oukej1/Home-automation/README.md

# Home-automation
Repository for home automation design, and codes.
