oukej1/Home-automation/House_Loucka/README.md

Folder for preparation of arduino and RPI based home automation for house in Loučka.
