oukej1/Home-automation/House_Loucka/ELI_tabulky.ods

Sheet: ZasuvkoveOkruhy
Rozvaděč | Podlaží | Místnost | Okruh | Počet | Popis | Příkon | Hnízda | počet
RH | 1NP | 102 | 100 | 6 | Zásuvky |  | 1 | 2
RH | 1NP | 102 | 101 | 1 | TV |  | 3 | 1 | 3
RH | 1NP | 102 | 102 | 1 | Myčka |  | 1 | 2 | 1
RH | 1NP | 102 | 103 | 1 | Mikrovlnná trouba |  | 1 | 2 | 1
RH | 1NP | 102 | 104 | 1 | Trouba | 3500W | 1 | 2 | 1
RH | 1NP | 102 | 105 | 5 | Zásuvky kuchyňská linka |  | 1 | 2
RH | 1NP | 102 | 106 | 1 | Lednice |  | 1 | 2 | 1
RH | 1NP | 102 | 107 | 1 | Digestoř |  | 1 | 1
RH | 1NP | 102 | 108 | 1 | Indukční varná deska | 7360W
RH | 1NP | 103;105 | 109 | 7 | Zásuvky
RH | 1NP | 103;104;105;106 | 110 | 5 | PC + AP
RH | 1NP | 104; 106 | 111 | 4 | Zásuvky
RH | 1NP | 108;109 | 112 | 5 | zásuvky
RH | 1NP | 110;101 | 113 | 3 | zásuvky
RH | 1NP | 110 | 114 | 1 | Pračka
RH | 1NP | 110 | 115 | 1 | Sušička
RP | 1NP | 100 | 116 | 4 | Zásuvky venkovní + robosekačka |  | 1 | 2
RP | 1NP | 113 | 117 | 2 | Zásuvky
RP | 1NP | 112;100 | 118 | 3 | Zásuvky – Soustruh | 6000W
RP | 1NP | 112;100 | 119 | 1 | Zásuvka 400V
RP | 1NP | 112;100 | 120 | 3 | Zásuvky
RP | 1NP | 100 | 121 | 1 | Zásuvka 400V |  | 1 | 1
RP | 1NP | 100 | 122 | 1 | Vodárna pitná voda (čerpadlo + 2 zásuvky úpravna) | 1550w + 2x100W | 3 | 2
RP | 1NP | 100 | 123 | 1 | Vodárna užitková voda | 910W | 1 | 2
RP | 1NP | 100 | 124 | 1 | Brána + videovrátný
RP | 1NP | 100 | 125 | 1 | Studna |  | 1 | 2
RP | 1NP | 100 | 126 | 1 | Dešťovka |  | 1 | 2
RH | 2NP | 202 | 201 | 5 | Zásuvky pracovna
RH | 2NP | 202 | 202 | 3 | Zásuvky pracovna PC + AP
RH | 2NP | 201;203;204 | 203 | 6 | Zásuvky + zásuvka koupelna skřínka
RH | 2NP | 206 | 204 | 5 | Zásuvky
RH | 2NP | 202 | 205 | 1 | Zásuvka Příprava – Přímotop možnost sjednotit s podlahovkou | 1000W
RH | 2NP | 206 | 206 | 1 | Zásuvka Příprava – Přímotop možnost sjednotit s podlahovkou | 1000W
RH | 2NP | 205 | 207 | 1 | Bojler | 2500W
RH | 2NP | 205 | 208 | 1 | Rekuperace
RH | 2NP | 205 | 209 | 1 | Slaboproudý rozvaděč
RH | 2NP | 205 | 210 | 1 | Rezerva
RH | 2NP | 200 | 211 | 1 | Zásuvka venkovní – vánoční osvětlení
RH | 2NP | 205 | 212 | 1 | Cirkulační čerpadlo

Sheet: Svetla
Rozvaděč | Podlaží | Místnost | Okruh | Počet | Popis | Arduino | SSR relay
RH | 1NP | 101 | L1011 | 1 | Hala Strop | Ard1 | SSR1
RH | 1NP | 101 | L1012 | 1 | Hala schody stěna | Ard1 | SSR1
RH | 1NP | 102 | L1021 | 1 | Jídelna strop | Ard1 | SSR1
RH | 1NP | 102 | L1022 | 1 | Kuchyň strop | Ard1 | SSR1
RH | 1NP | 102 | L1023 | 1 | Kuchyň Led pásek linka | Ard1 | SSR1
RH | 1NP | 102 | L1024 | 1 | Obývák stůl | Ard1 | SSR1
RH | 1NP | 102 | L1024 | 1 | Obývák gauč | Ard1 | SSR1
RH | 1NP | 102 | L1025 | 1 | Vstup do denní místnosti | Ard1 | SSR1
RH | 1NP | 103 | L1031 | 1 | Strop pracovna | Ard1 | SSR2
RH | 1NP | 104 | L1041 | 2 | Strop chodba | Ard1 | SSR2
RH | 1NP | 104 | L1042 | 2 | Led světlo ú podlahy | Ard1 | SSR2
RH | 1NP | 105 | L1051 | 1 | Strop Pokoj I | Ard1 | SSR2
RH | 1NP | 106 | L1061 | 1 | Strop Pokoj II | Ard1 | SSR2
RH | 1NP | 107 | L1071 | 1 | Strop šatna | Ard1 | SSR2
RH | 1NP | 108 | L1081 | 1 | Strop ložnice | Ard1 | SSR2
RH | 1NP | 109 | L1091 | 2 | Koupelna strop + skřínka | Ard1 | SSR2
RH | 1NP | 110 | L1101 | 3 | Koupelna strop + 2x skřínka | Ard1 | SSR3
RH | 1NP | 111 | L1111 | 1 | WC strop | Ard1 | SSR3
RH | 1NP | 100 | L1001 | 2 | Exteriér světla u vstupu | Ard1 | SSR3
RH | 1NP | 100 | L1002 | 2 | Exteriér světla terasa | Ard1 | SSR3
RH | 1NP | 100 | L1003 | 5 | Exteriér světla pokoje | Ard1 | SSR3
RH | 1NP | 100 | L1004 | 1 | Exteriér světlo ložnice | Ard1 | SSR3
RP | 1NP | 112 | L1121 | 2 | Strop dílna | Ard5 | SSR12
RP | 1NP | 113 | L1131 | 1 | Strop sklad | Ard5 | SSR12
RH | 2NP | 202 | L2021 | 1 | Strop pracovna II | Ard1 | SSR3
RH | 2NP | 201 | L2011 | 2 | Strop Galerie | Ard1 | SSR3
RH | 2NP | 201 | L1012 | 1 | Schodiště | Ard1 | SSR4
RH | 2NP | 203 | L2031 | 1 | Šatna | Ard1 | SSR4
RH | 2NP | 204 | L2041 | 2 | Koupelna strop + skřínka | Ard1 | SSR4
RH | 2NP | 205 | L2051 | 1 | Technická místnost | Ard1 | SSR4
RH | 2NP | 206 | L2061 | 1 | Herna | Ard1 | SSR4
RH | 2NP | 200 | L2001 | 1 | Venkovní plochá střecha | Ard1 | SSR4

Sheet: Topeni
Rozvaděč | Podlaží | Místnost | Okruh | Počet | Popis | Příkon | Arduino | SSR relay
RH | 1NP | 101 | H1011 | 1 | Podlahové topení | 400 W | Ard2 | SSR5
RH | 1NP | 102 | H1021 | 1 | Podlahové topení | 1700 W | Ard2 | SSR5
RH | 1NP | 102 | H1022 | 1 | Podlahové topení | 950 W | Ard2 | SSR5
RH | 1NP | 103 | H1031 | 1 | Podlahové topení | 520 W | Ard2 | SSR5
RH | 1NP | 105 | H1051 | 1 | Podlahové topení | 750 W | Ard2 | SSR5
RH | 1NP | 106 | H1061 | 1 | Podlahové topení | 750 W | Ard2 | SSR5
RH | 1NP | 108 | H1081 | 1 | Podlahové topení | 600 W | Ard2 | SSR5
RH | 1NP | 109 | H1091 | 1 | Podlahové topení | 200 W | Ard2 | SSR5
RH | 1NP | 109 | H1092 | 1 | Žebřík | 500 W | Ard2 | SSR6
RH | 1NP | 110 | H1101 | 1 | Podlahové topení | 550 W | Ard2 | SSR6
RH | 1NP | 110 | H1102 | 1 | Žebřík | 500 W | Ard2 | SSR6
RH | 1NP | 111 | H1111 | 1 | Žebřík | 310 W | Ard2 | SSR6
RP | 1NP | 112+100 | H1121 | 3 | Vyhřívaná střešní vpusť | 30 W | Ard5 | SSR12
RH | 2NP | 202 | H2021 | 1 | Podlahové topení | 1700 W | Ard2 | SSR6
RH | 2NP | 204 | H2041 | 1 | Podlahové topení | 550W | Ard2 | SSR6
RH | 2NP | 204 | H2042 | 1 | Žebřík | 500 W | Ard2 | SSR6
RH | 2NP | 206 | H2061 | 1 | Podlahové topení | 1300 W | Ard2 | SSR6
RP | 1NP | 112 | H1122 | 1 | Příomotop | 1000W | Ard5 | SSR12
RP | 1NP | 112 | H1123 | 1 | Ventilátor | xx | Ard5 | SSR12

Sheet: Zaluzie
Rozvaděč | Podlaží | Místnost | Okruh | Počet | Popis | Příkon | Arduino
RH | 1NP | 102 | SH1021 | 1 | Žaluzie HS fix | 95W | Ard2 | SSR9
RH | 1NP | 102 | SH1022 | 1 | Žaluzie HS otvírací | 95W | Ard2 | SSR9
RH | 1NP | 102 | SH1023 | 1 | Žaluzie Fix rohové | 95W | Ard2 | SSR9
RH | 1NP | 102 | SH1024 | 1 | Žaluzie Kuchyňská linka | 95W | Ard2 | SSR9
RH | 1NP | 103 | SH1031 | 1 | Žaluzie Pracovna | 95W | Ard2 | SSR10
RH | 1NP | 105 | SH1051 | 1 | Žaluzie Pokoj I | 95W | Ard2 | SSR10
RH | 1NP | 106 | SH1061 | 1 | Žaluzie Pokoj II | 95W | Ard2 | SSR10
RH | 1NP | 108 | SH1081 | 1 | Žaluzie Ložnice | 95W | Ard2 | SSR10
RH | 2NP | 202 | SH2021 | 1 | Žaluzie Pracovna II | 95W | Ard2 | SSR11
RH | 2NP | 206 | SH2061 | 1 | Žaluzie Herna | 95W | Ard2 | SSR11

Sheet: Zvuk
Rozvaděč | Podlaží | Místnost | Okruh | Počet | Popis | Příkon
RH | 1NP | 102 | SND1021 | 3 | Reporduktor kuchyně + obývák
RH | 1NP | 103 | SND1031 | 1 | Reporduktor Pracovna I
RH | 1NP | 105 | SND1051 | 1 | Reproduktor Pokoj I
RH | 1NP | 106 | SND1061 | 1 | Reproduktor Pokoj II
RH | 2NP | 202 | SND2021 | 1 | Reproduktor Pracovna II
RH | 2NP | 206 | SND2061 | 1 | Repoduktor Herna

Sheet: FVE
Rozvaděč | Podlaží | Místnost | Počet | Popis | Typ
RH | 1NP | 113 | 1 | Střídač | SUN-10K-SG04LP3
RH | 1NP | 113 | 1 | Baterie | Somi 10,24 kWh
RH | 1NP | Exteriér | 2 | Wallbox | EVmate 01/2-3-16 STR

Sheet: Sheet8
Distribution box | ID | Room | Sensor | Count | Arduino | Pin count
RH | 101 | hala | DHT22 | 1 | Ard3 | 1
RH | 102 | denní místnost | DHT22
RH | 103 | Pracovna 1 | DHT22
RH | 104 | chodba | DHT22 | 1 | Ard3 | 1
RH | 105 | Pokoj 1 | DHT22
RH | 106 | Pokoj 2 | DHT22
RH | 107 | Šatna | DHT22 | 1 | Ard3 | 1
RH | 108 | Ložnice | DHT22
RH | 109 | Koupelna II | DHT22 | 1 | Ard3 | 1
RH | 110 | Koupelna I | DHT22 | 1 | Ard3 | 1
RH | 111 | WC | DHT22 | 1 | Ard3 | 1
RP1 | 112 | Dílna | DHT22
RP1 | 113 | Sklad | DHT22 | 1 | Ard5 | 1
RH | 201 | Galerie | DHT22 | 1 | Ard3 | 1
RH | 202 | Pracovna 2 | DHT22
RH | 203 | Šatna | DHT22 | 1 | Ard3 | 1
RH | 204 | koupelna | DHT22 | 1 | Ard3 | 1
RH | 205 | Technologie | DHT22 | 1 | Ard3 | 1
RH | 206 | Herna | DHT22
RP1 | 000 | Outdoor | DHT22 | 1 | Ard5 | 1
RH | 101 | hala | HC-SR501 | 1 | Ard3 | 1
RH | 102 | denní místnost | HC-SR501 | 2 | Ard3 | 2
RH | 103 | Pracovna 1 | HC-SR501 | 1 | Ard3 | 1
RH | 104 | chodba | HC-SR501 | 1 | Ard3 | 1
RH | 105 | Pokoj 1 | HC-SR501 | 1 | Ard3 | 1
RH | 106 | Pokoj 2 | HC-SR501 | 1 | Ard3 | 1
RH | 107 | Šatna | HC-SR501 | 1 | Ard3 | 1
RH | 108 | Ložnice | HC-SR501 | 1 | Ard3 | 1
RH | 109 | Koupelna II | HC-SR501 | 1 | Ard3 | 1
RH | 110 | Koupelna I | HC-SR501 | 1 | Ard3 | 1
RH | 111 | WC | HC-SR501 | 1 | Ard3 | 1
RP1 | 112 | Dílna | HC-SR501 | 1 | Ard5 | 1
RP1 | 113 | Sklad | HC-SR501 | 1 | Ard5 | 1
RH | 201 | Galerie | HC-SR501 | 1 | Ard3 | 1
RH | 202 | Pracovna 2 | HC-SR501 | 1 | Ard3 | 1
RH | 203 | Šatna | HC-SR501 | 1 | Ard3 | 1
RH | 204 | koupelna | HC-SR501 | 1 | Ard3 | 1
RH | 205 | Technologie | HC-SR501 | 1 | Ard3 | 1
RH | 206 | Herna | HC-SR501 | 1 | Ard3 | 1
RP1 | 000 | Outdoor | HC-SR501 | 3 | Ard5 | 3
RH | 101 | hala | DS18B20 5m | 1 | Ard3 | 1
RH | 102 | denní místnost | DS18B20 5m | 2 | Ard3 | 0
RH | 103 | Pracovna 1 | DS18B20 5m | 1 | Ard3 | 0
RH | 104 | chodba | DS18B20 5m |  | Ard3 | 0
RH | 105 | Pokoj 1 | DS18B20 5m | 1 | Ard3 | 0
RH | 106 | Pokoj 2 | DS18B20 5m | 1 | Ard3 | 0
RH | 107 | Šatna | DS18B20 5m |  | Ard3 | 0
RH | 108 | Ložnice | DS18B20 5m | 1 | Ard3 | 0
RH | 109 | Koupelna II | DS18B20 5m | 1 | Ard3 | 0
RH | 110 | Koupelna I | DS18B20 5m | 1 | Ard3 | 0
RH | 111 | WC | DS18B20 5m |  | Ard3 | 0
RP1 | 112 | Dílna | DS18B20 5m |  |  | 0
RP1 | 113 | Sklad | DS18B20 5m |  |  | 0
RH | 201 | Galerie | DS18B20 5m |  | Ard3 | 0
RH | 202 | Pracovna 2 | DS18B20 5m | 1 | Ard3 | 0
RH | 203 | Šatna | DS18B20 5m |  | Ard3 | 0
RH | 204 | koupelna | DS18B20 5m | 1 | Ard3 | 0
RH | 205 | Technologie | DS18B20 5m |  | Ard3 | 0
RH | 206 | Herna | DS18B20 5m | 1 | Ard3 | 0
RP1 | 000 | Outdoor | DS18B20 5m
RH | 101 | hala | TSL2591
RH | 102 | denní místnost | TSL2591 | 2 | Ard3 | 2
RH | 103 | Pracovna 1 | TSL2591 | 1 | Ard3 | 1
RH | 104 | chodba | TSL2591
RH | 105 | Pokoj 1 | TSL2591 | 1 | Ard3 | 1
RH | 106 | Pokoj 2 | TSL2591 | 1 | Ard3 | 1
RH | 107 | Šatna | TSL2591
RH | 108 | Ložnice | TSL2591 | 1 | Ard3 | 1
RH | 109 | Koupelna II | TSL2591
RH | 110 | Koupelna I | TSL2591
RH | 111 | WC | TSL2591
RP1 | 112 | Dílna | TSL2591
RP1 | 113 | Sklad | TSL2591
RH | 201 | Galerie | TSL2591
RH | 202 | Pracovna 2 | TSL2591 | 1 | Ard3 | 1
RH | 203 | Šatna | TSL2591
RH | 204 | koupelna | TSL2591
RH | 205 | Technologie | TSL2591
RH | 206 | Herna | TSL2591 | 1 | Ard3 | 1
RP1 | 000 | Outdoor | TSL2591 | 4 | Ard5 | 4
RH | 101 | hala | Magnetic door sensor | 1 | Ard4 | 1
RH | 102 | denní místnost | Magnetic door sensor | 3 | Ard4 | 3
RH | 103 | Pracovna 1 | Magnetic door sensor | 2 | Ard4 | 2
RH | 104 | chodba | Magnetic door sensor
RH | 105 | Pokoj 1 | Magnetic door sensor | 2 | Ard4 | 2
RH | 106 | Pokoj 2 | Magnetic door sensor | 2 | Ard4 | 2
RH | 107 | Šatna | Magnetic door sensor
RH | 108 | Ložnice | Magnetic door sensor | 2 | Ard4 | 2
RH | 109 | Koupelna II | Magnetic door sensor
RH | 110 | Koupelna I | Magnetic door sensor | 1 | Ard4 | 1
RH | 111 | WC | Magnetic door sensor
RP1 | 112 | Dílna | Magnetic door sensor | 1 | Ard5 | 1
RP1 | 113 | Sklad | Magnetic door sensor | 1 | Ard5 | 1
RH | 201 | Galerie | Magnetic door sensor
RH | 202 | Pracovna 2 | Magnetic door sensor | 2 | Ard4 | 2
RH | 203 | Šatna | Magnetic door sensor
RH | 204 | koupelna | Magnetic door sensor
RH | 205 | Technologie | Magnetic door sensor
RH | 206 | Herna | Magnetic door sensor | 2 | Ard4 | 2
RP1 | 000 | Outdoor | Magnetic door sensor
RH | 101 | hala | SCD41
RH | 102 | denní místnost | SCD41 | 2 | Ard4 | 2
RH | 103 | Pracovna 1 | SCD41 | 1 | Ard4 | 1
RH | 104 | chodba | SCD41
RH | 105 | Pokoj 1 | SCD41 | 1 | Ard4 | 1
RH | 106 | Pokoj 2 | SCD41 | 1 | Ard4 | 1
RH | 107 | Šatna | SCD41
RH | 108 | Ložnice | SCD41 | 1 | Ard4 | 1
RH | 109 | Koupelna II | SCD41
RH | 110 | Koupelna I | SCD41
RH | 111 | WC | SCD41
RP1 | 112 | Dílna | SCD41 | 1 | Ard5 | 1
RP1 | 113 | Sklad | SCD41
RH | 201 | Galerie | SCD41
RH | 202 | Pracovna 2 | SCD41 | 1 | Ard4 | 1
RH | 203 | Šatna | SCD41
RH | 204 | koupelna | SCD41
RH | 205 | Technologie | SCD41
RH | 206 | Herna | SCD41 | 1 | Ard4 | 1
RP1 | 000 | Outdoor | SCD41

Sheet: Sensors_Incl_CO2
ID | Room | Area | DHT22 | HC-SR501 | DS18B20 5m | TSL2591 | Magnetic door sensor | SCD41 | Total
101 | hala | 6.34 | 1 | 1 | 1 |  | 1 |  | 4
102 | denní místnost | 43.14 |  | 2 | 2 | 2 | 3 | 2 | 11
103 | Pracovna 1 | 8.17 |  | 1 | 1 | 1 | 2 | 1 | 6
104 | chodba | 5.65 | 1 | 1 |  |  |  |  | 2
105 | Pokoj 1 | 12.16 |  | 1 | 1 | 1 | 2 | 1 | 6
106 | Pokoj 2 | 12.15 |  | 1 | 1 | 1 | 2 | 1 | 6
107 | Šatna | 2.12 | 1 | 1 |  |  |  |  | 2
108 | Ložnice | 10.04 |  | 1 | 1 | 1 | 2 | 1 | 6
109 | Koupelna II | 2.33 | 1 | 1 | 1 |  |  |  | 3
110 | Koupelna I | 6.23 | 1 | 1 | 1 |  | 1 |  | 4
111 | WC | 1.2 | 1 | 1 |  |  |  |  | 2
112 | Dílna | 14.62 |  | 1 |  |  | 1 | 1 | 3
113 | Sklad | 5.83 | 1 | 1 |  |  | 1 |  | 3
201 | Galerie | 6.21 | 1 | 1 |  |  |  |  | 2
202 | Pracovna 2 | 27.66 |  | 1 | 1 | 1 | 2 | 1 | 6
203 | Šatna | 5.05 | 1 | 1 |  |  |  |  | 2
204 | koupelna | 6.44 | 1 | 1 | 1 |  |  |  | 3
205 | Technologie | 3.79 | 1 | 1 |  |  |  |  | 2
206 | Herna | 21.78 |  | 1 | 1 | 1 | 2 | 1 | 6
000 | Outdoor | 0 | 1 | 3 |  | 4 |  |  | 8
 | Total |  | 12 | 23 | 12 | 12 | 19 | 9 | 87
