oukej1/Home-automation/House_Loucka/Sensor_boxes/Sensor_Box_THCO_assembly.FCStd

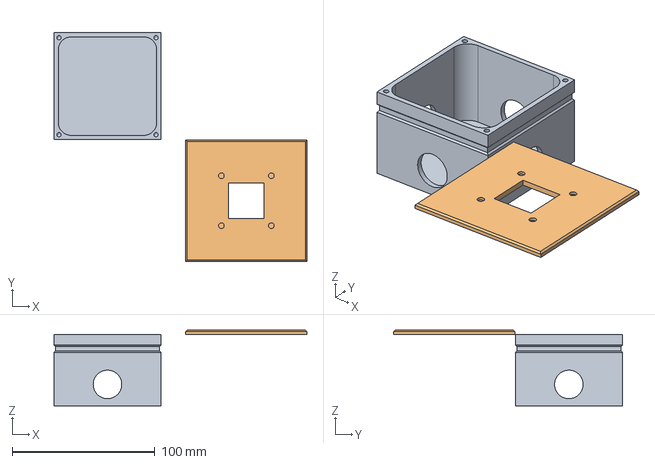
[picture p1: CAD file, 2024-05-08]
House_Loucka/Sensor_boxes/Sensor_Box_THCO_assembly.FCStd
177.3 x 160.3 x 53.0 mm
Sensor_box_001
Sensor_cover_Tem_hum_CO_001
