oukej1/Home-automation/House_Loucka/Sensor_boxes/Sensor_box.FCStd

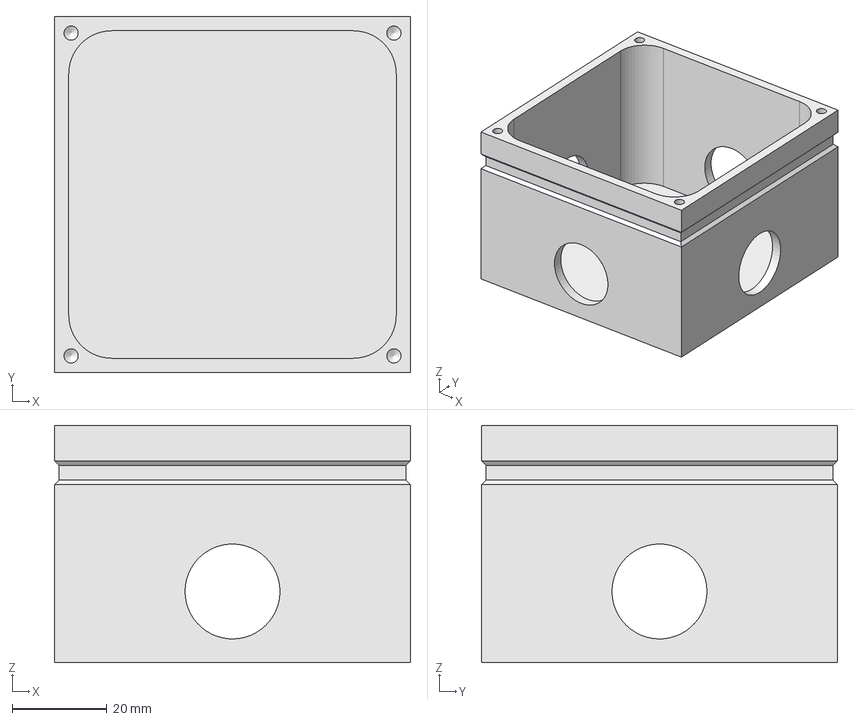
[picture p2: CAD file, 2024-05-08]
House_Loucka/Sensor_boxes/Sensor_box.FCStd
75.0 x 75.0 x 50.0 mm
