oukej1/Home-automation/House_Loucka/Sensor_boxes/Sensor_cover_Tem_hum_CO.FCStd

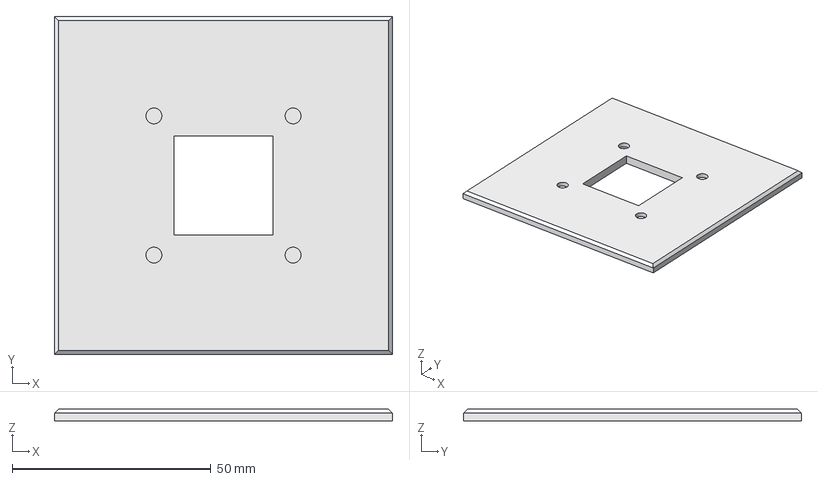
[picture p3: CAD file, 2024-05-08]
House_Loucka/Sensor_boxes/Sensor_cover_Tem_hum_CO.FCStd
85.0 x 85.0 x 3.00 mm
