oukej1/Home-automation/Test_house_Hurka/README.md

Folder for testing of arduino and RPI based home automation in Hůrka.
