oukej1/Home-automation/(threads)

Thread 1 (2024-05-28):

Vyřešit u světel

oukej1, 2024-05-28:
Rozvržení žárovek venku a jejich ovládání L1003 - L1006
Potvrdit obývák - zrušení středových světel
Potvrdit LED pásky v chodbě L1042
Potvrdit 2x B1007 tlačítka
Potvrdit B1001
Potvrdit B1022,1023

oukej1, 2024-06-27:
Vše L1003
V obýváku zrušeno středové
Led potvrzeny 2 ks
B1007 zrušeno
B1001 přesunuto a jedno vevnitř
B1022.1023 potvrzeno lednice je 20cm od kraje

Closed 2024-06-27.
