oukej1/Home-automation/House_Loucka/Rozvadece/Rozvaděč RE1_HonzaLazecky.pdf

Akce: | Název: Liniové schéma RE1 | StavbyDay s.r.o. Karasova 1130/23 709 00, Ostrava-Mariánské Hory IČ: 07522240 DIČ: CZ07522240 mobil: +420 722 946 876 email: info@StavbyDay.cz | Datum: 22.09.2022 | Vypracoval: | Schválil: RD Lazečtí | Počet listů:
Místo: Olbramice | | | | | | Číslo listu:

- ROZVADĚČ V OCELOPLECHOVÉM SKŘÍŇOVÉM PROVEDENÍ: 1100x1800x400mm (MAX. rozměry) - MONTÁŽ V PROVEDENÍ NA OMÍTKU - PŘÍVOD SHORA, VÝVODY VRCHEM - OBDÉLNÍKOVÉ OTVORY PRO SILOVÉ A SLABOPROUDÉ KABELY ZVLÁŠŤ - SVORKOVNICE N a PE NESCHOVÁVAT ZA SEBE - KRYTÍ: IP40/IP20 - PŘED INSTALACÍ PRVKU LOXONE, NEJPRVE DŮKLADNĚ PROSTUDOVAT NÁVOD

1800 mm

1100 mm

400 mm

# ROZVODNÁ SOUSTAVA: 3 NPE, AC 50Hz, 400V / TN-C-S

ZÁKLADNÍ OCHRANA PŘED NEBEZPEČNÝM DOTYKEM DLE ČSN 33 2000-4-41: SAMOČINNÝM ODPOJENÍM OD ZDROJE

# ZVÝŠENÁ: DOPLŇKOVÝM POSPOJOVÁNÍM, PROUDOVÝM CHRÁNIČEM - V NÁSLEDNÝCH OBVODECH

# Liniové schéma rozvodnice

Prvky Loxone, které dodá fa StavbyDay: 1x TDK-Lambda DRF100-24-4,2A (ZD1) 1x TDK-Lambda DRF100-24-0,4A (ZD2) 3x TDK-Lambda DRF240-24-10A (ZD3, ZD4, ZD5) 1x Loxone 3-fázový elektroměr (Modbus) (U1) 1x Loxone Miniserver 2. generace (U2) 4x Loxone Relé Extension (U3, U4, U5, U6) 2x Loxone Modbus Extension (U7, U8) 2x Loxone 1-Wire Extension (U9, U10) 1x Loxone Air Base Extension (U11) 1x Loxone DI Extension (U12) 1x Loxone Tree Extension (U13) 3x Loxone RGBW 24V Dimmer Tree (U14, U15) 1x Loxone AduioServer (U16) 1x Stereo Extension (U17) - pouze vynechat místo pro případné dosazení

Pro propojení datových linek „LOXONE bus”, „TREE bus”, „Tree Turbo”, „Modbus” použít kroucený pár. Propojit všechny mínusové svorky „-V” všech 24VDC zdrojů.

| X1 X2 X3 | X6
H1 | H4 IN1 | T1 T2 T3 T4 T5 T6 T7 T8 T9 T10 T11 T12 | T15 T16 K1 K2

# Silové svorky 230VAC

# Slaboproudé svorky 24VDC

# U2(9p) U3(9p) U4(9p) U5(9p) U6(9p) U7(2p)

U13(2p)

# U8(2p) U9(2p) U10(2p) U11(2p) U12(2p)

# Přibližné rozmístění a pořadí prvků Loxone

X4 | X7 U14(2p)
H3 | T13 T14

U16(9p)

A1

U15(2p)

X5
IN2

U16(2p)

U1

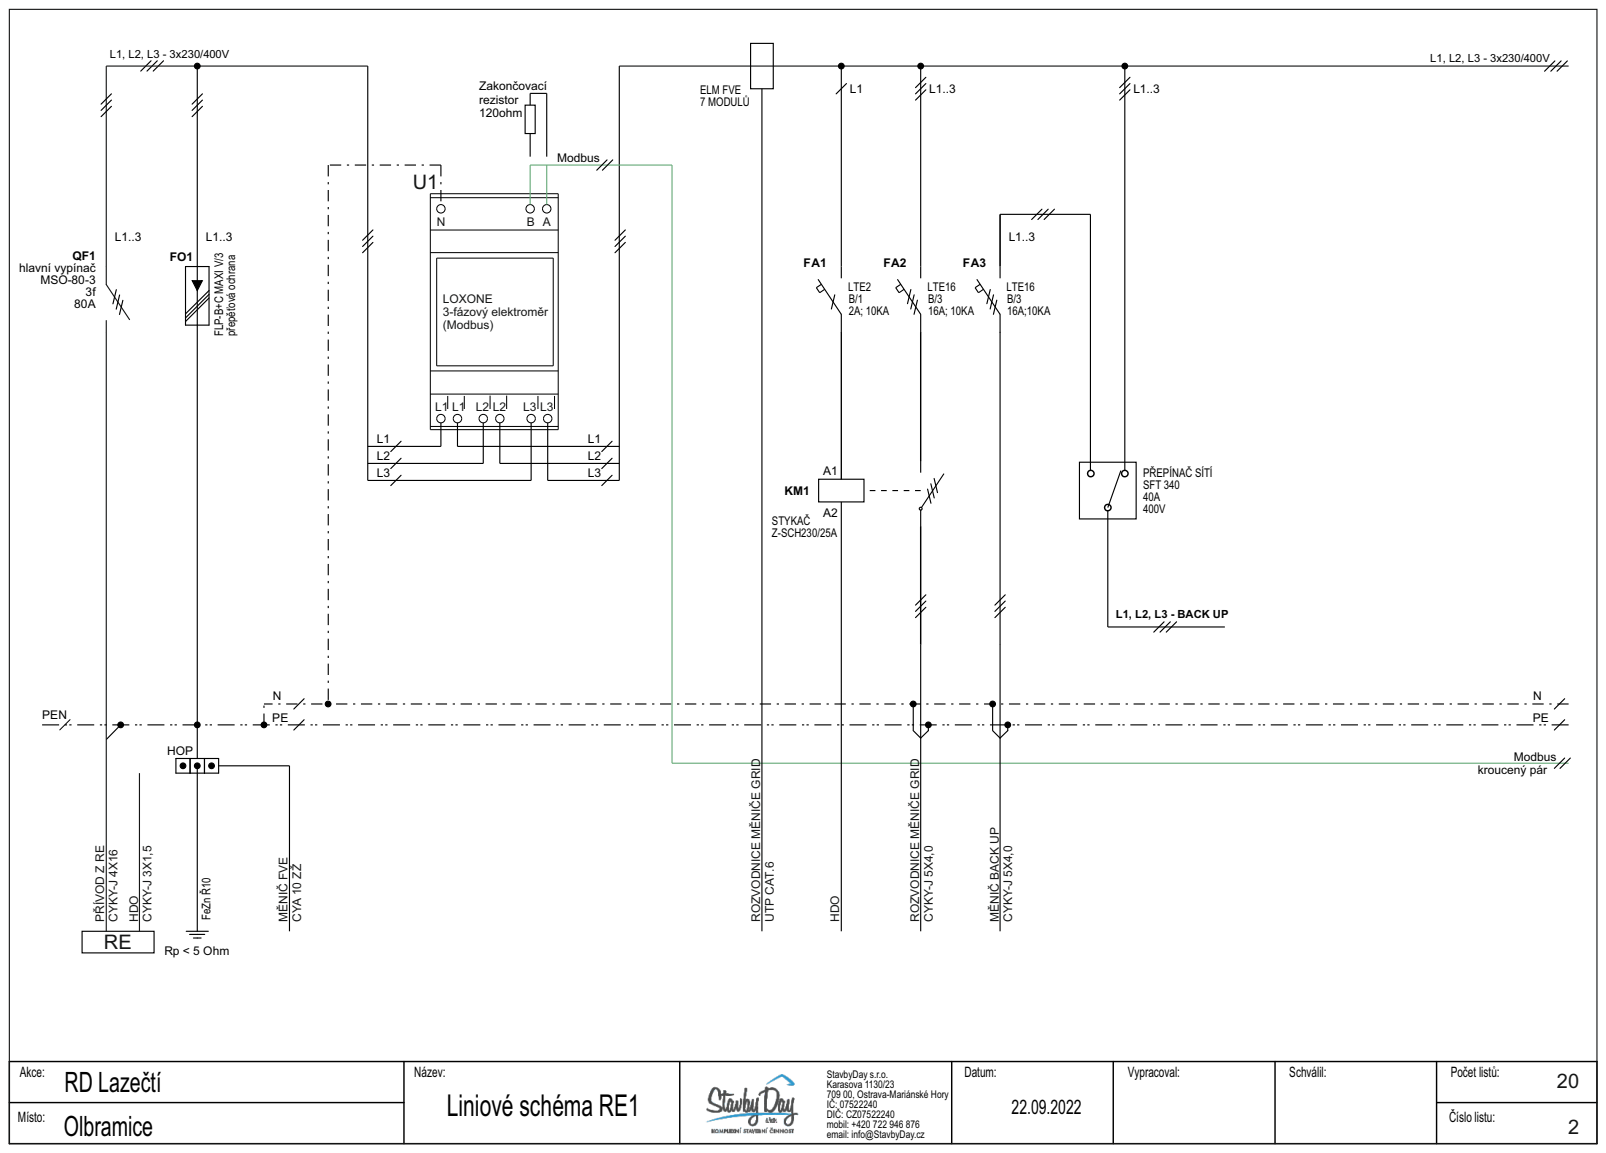
[picture p4: page 2]
QF1 hlavní vypínač MSO-80-3 3f 80A; FeZn Ř10; Rp < 5 Ohm; HOP; FLP-B+C MAXI V/3; přepěťová ochrana; PEN; LOXONE 3-fázový elektroměr (Modbus); Modbus; Zakončovací rezistor 120ohm; kroucený pár; PŘÍVOD Z RE; CYKY-J 4X16; HDO; CYKY-J 3X1,5; LTE16 B/3 16A;10KA; CYKY-J 5X4,0; LTE16 B/3 16A; 10KA; LTE2 B/1 2A; 10KA; MĚNIČ FVE CYA 10 ZŽ; PŘEPÍNAČ SÍTÍ SFT 340 40A 400V; STYKAČ Z-SCH230/25A; L1, L2, L3 - BACK UP; UTP CAT.6; ELM FVE 7 MODULŮ

L2 | L2
L3 | L3

ROZVODNICE MĚNIČE GRID

MĚNIČ BACK UP

# FA101ZÁSUVKA TERASA

# FA102ZÁSUVKA GARÁŽ

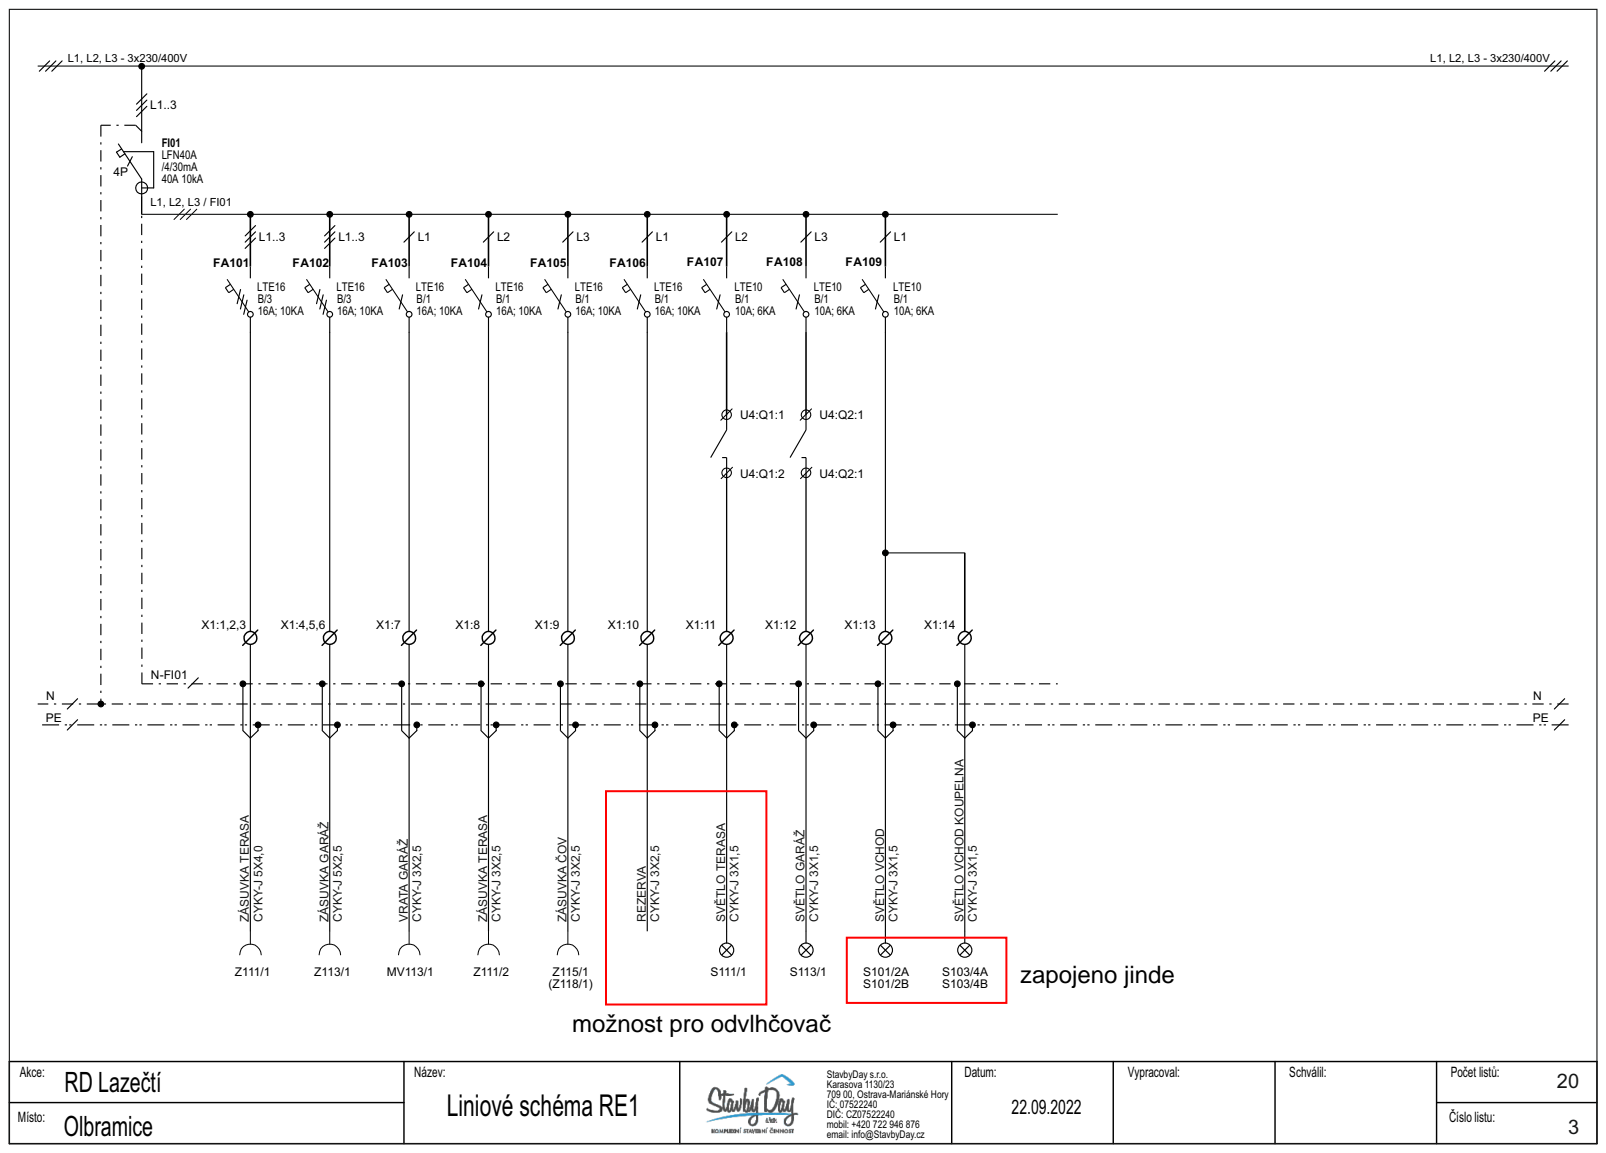
[picture p5: page 3]
FI01 LFN40A /4/30mA 40A 10kA 4P; LTE16 B/3 16A; 10KA; CYKY-J 5X4,0; CYKY-J 5X2,5; FA103VRATA GARÁŽ; CYKY-J 3X2,5; LTE16 B/1 16A; 10KA; FA105ZÁSUVKA ČOV; FA106REZERVA; LTE10 B/1 10A; 6KA; SVĚTLO TERASA; CYKY-J 3X1,5; FA104ZÁSUVKA TERASA; SVĚTLO VCHOD; SVĚTLO GARÁŽ; možnost pro odvlhčovač; zapojeno jinde

X1:14 SVĚTLO VCHOD KOUPELNA

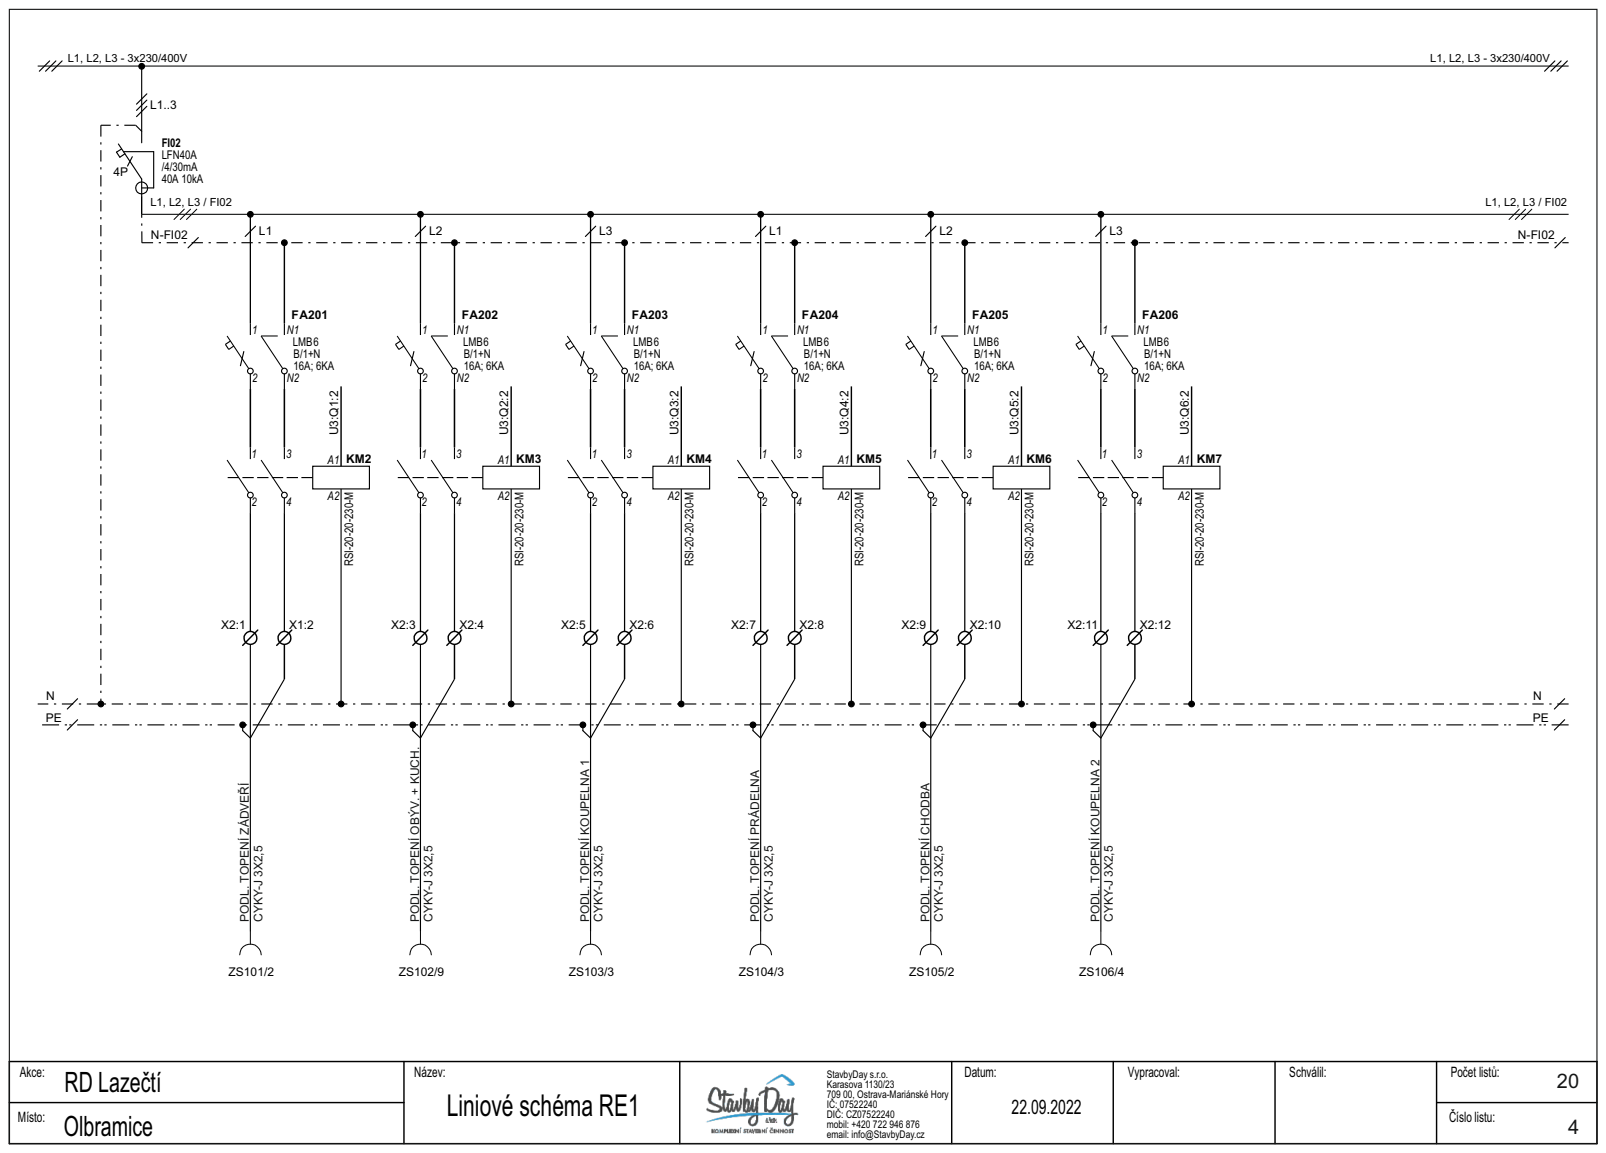
[picture p6: page 4]
FI02 LFN40A /4/30mA 40A 10kA 4P; LMB6 B/1+N 16A; 6KA; RSI-20-20-230-M; CYKY-J 3X2,5

PODL. TOPENÍ OBÝV. + KUCH.

PODL. TOPENÍ KOUPELNA 1

PODL. TOPENÍ PRÁDELNA

PODL. TOPENÍ KOUPELNA 2

PODL. TOPENÍ ZÁDVEŘÍ

PODL. TOPENÍ CHODBA

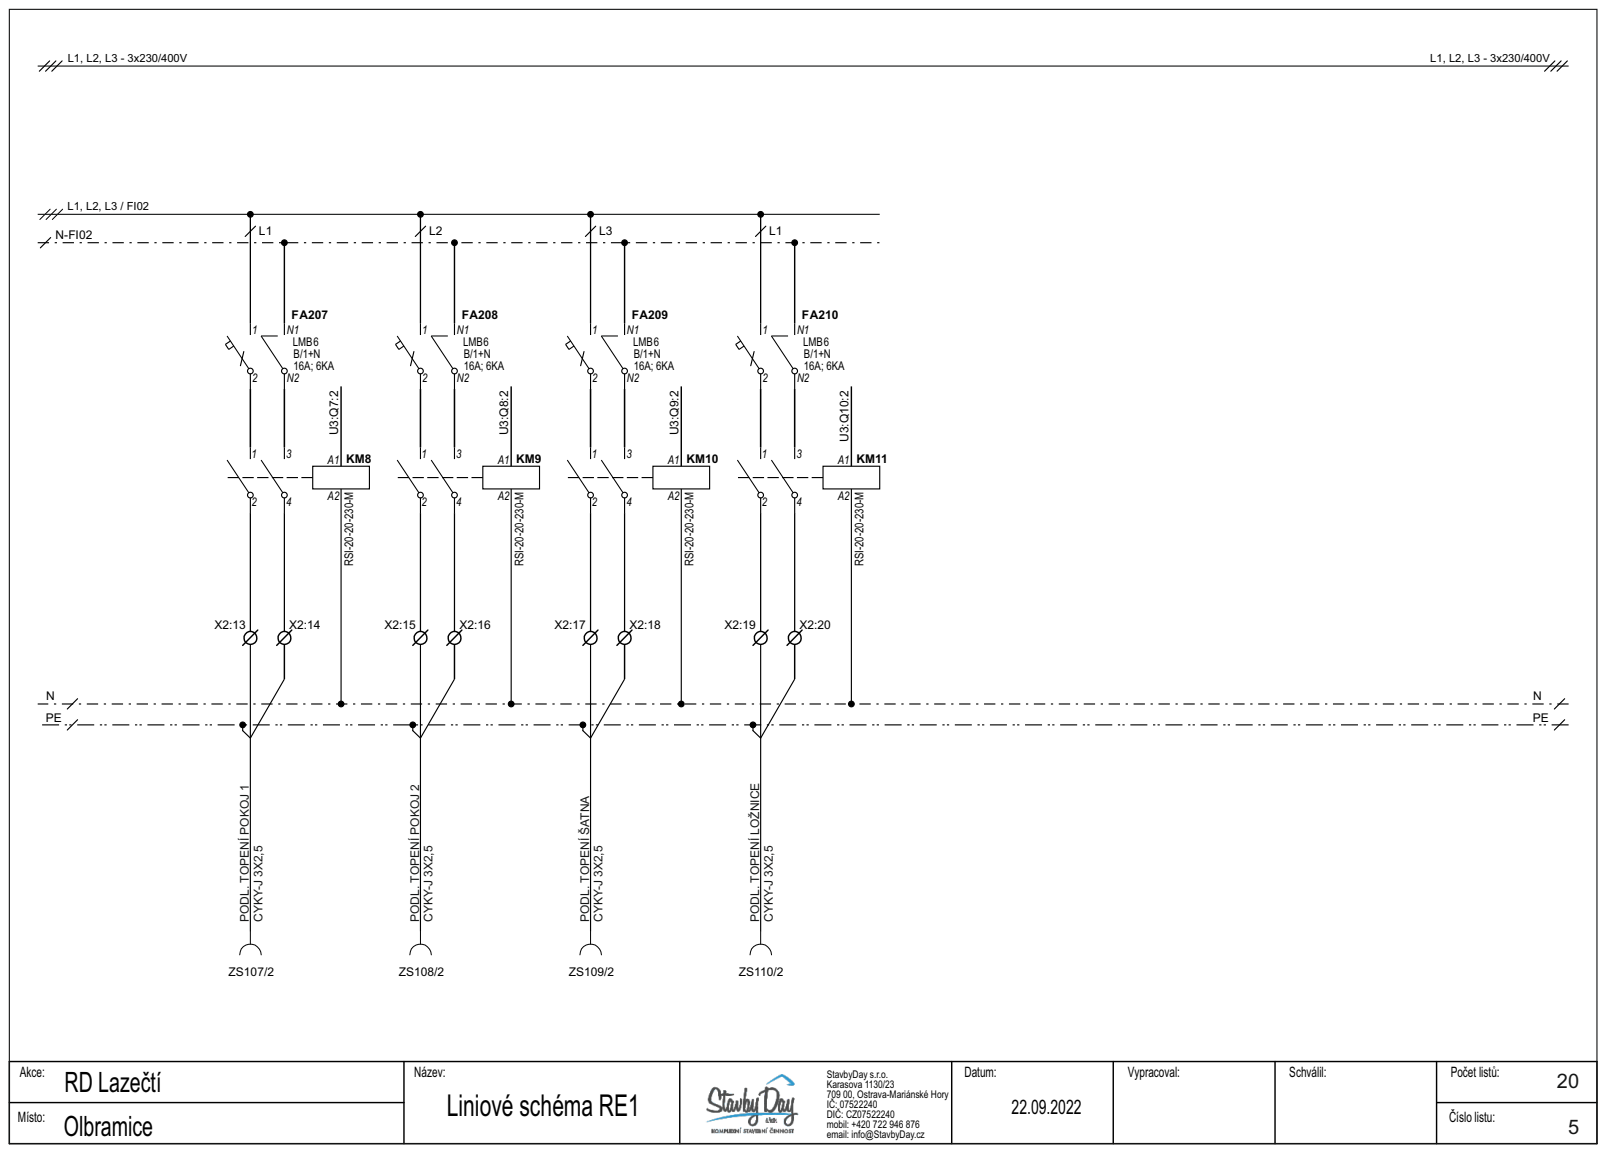
[picture p7: page 5]
LMB6 B/1+N 16A; 6KA; CYKY-J 3X2,5; RSI-20-20-230-M

PODL. TOPENÍ POKOJ 1

PODL. TOPENÍ POKOJ 2

PODL. TOPENÍ LOŽNICE

PODL. TOPENÍ ŠATNA

# FA308ZÁSUVKY PRACOVNA

# FA301HORNÍ

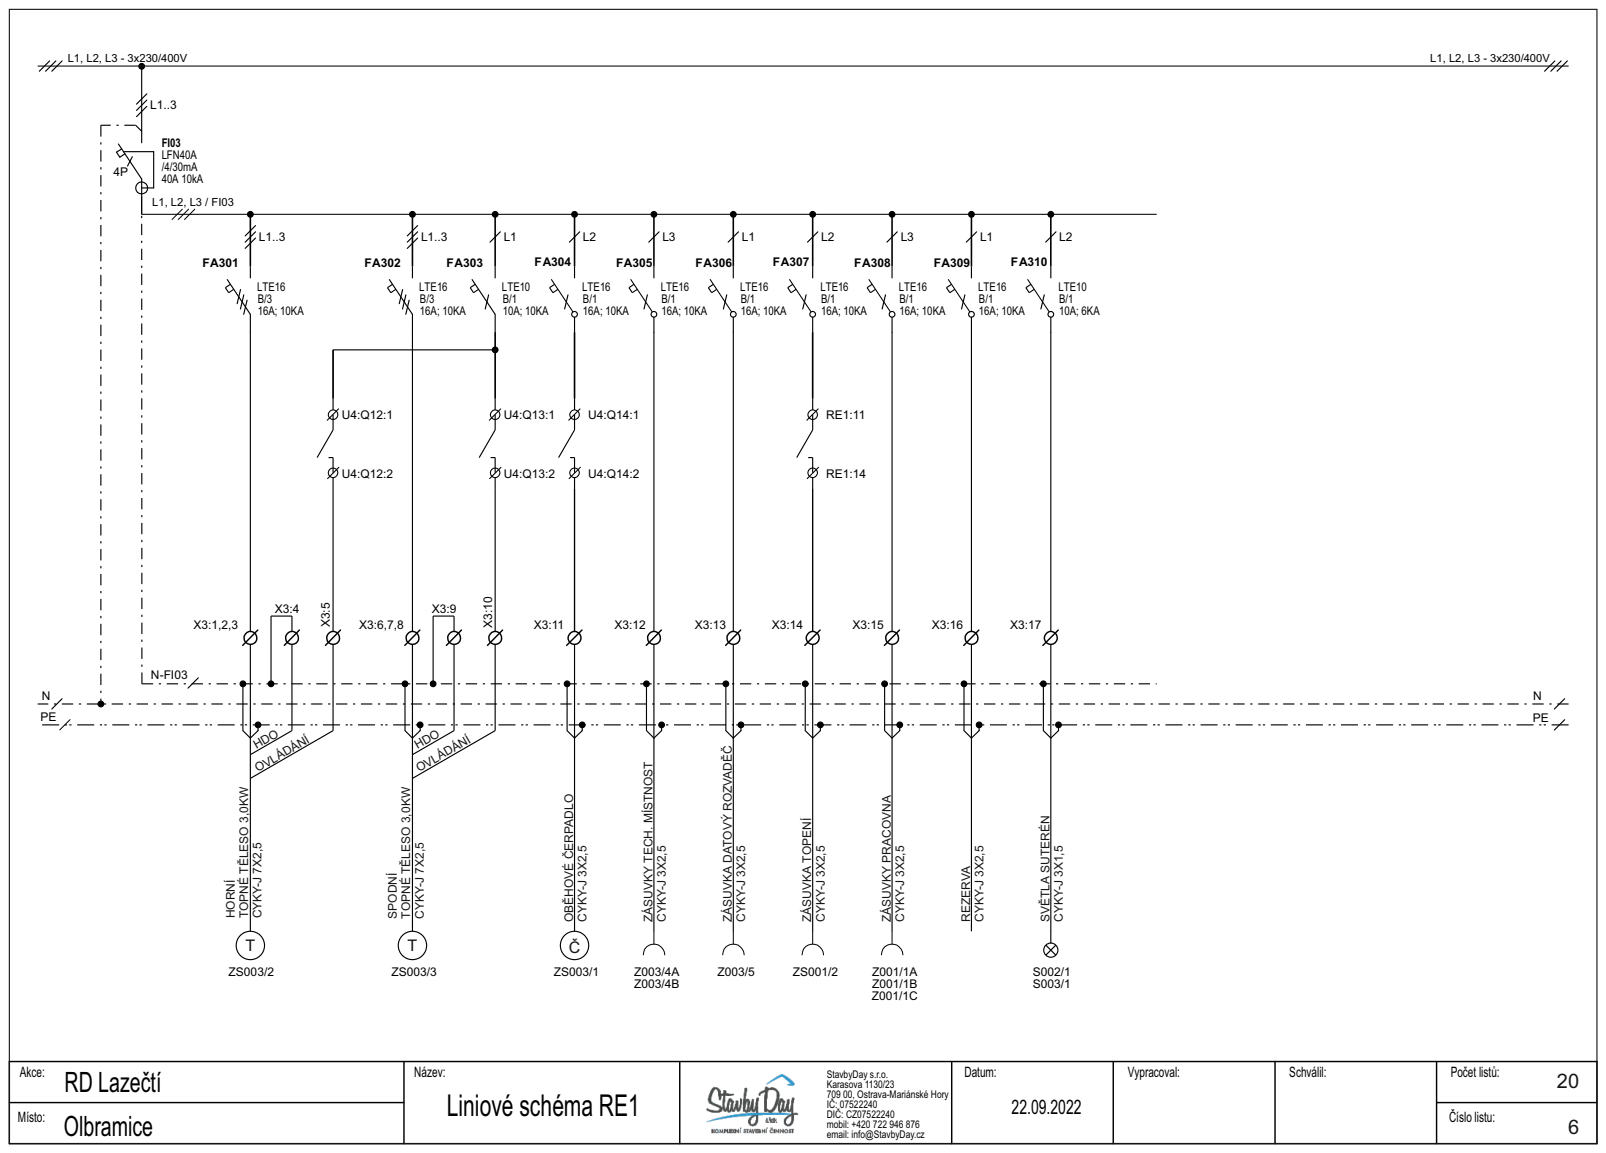
[picture p8: page 6]
FI03 LFN40A /4/30mA 40A 10kA 4P; CYKY-J 3X2,5; LTE16 B/1 16A; 10KA; LTE16 B/3 16A; 10KA; TOPNÉ TĚLESO 3,0KW; CYKY-J 7X2,5; LTE10 B/1 10A; 10KA; SPODNÍ; HDO OVLÁDÁNÍ; OBĚHOVÉ ČERPADLO; ZÁSUVKA TOPENÍ; FA309REZERVA; LTE10 B/1 10A; 6KA; SVĚTLA SUTERÉN; CYKY-J 3X1,5

ZÁSUVKA DATOVÝ ROZVADĚČ

ZÁSUVKY TECH. MÍSTNOST

# FA401ZÁSUVKA VARNÁ DESKA

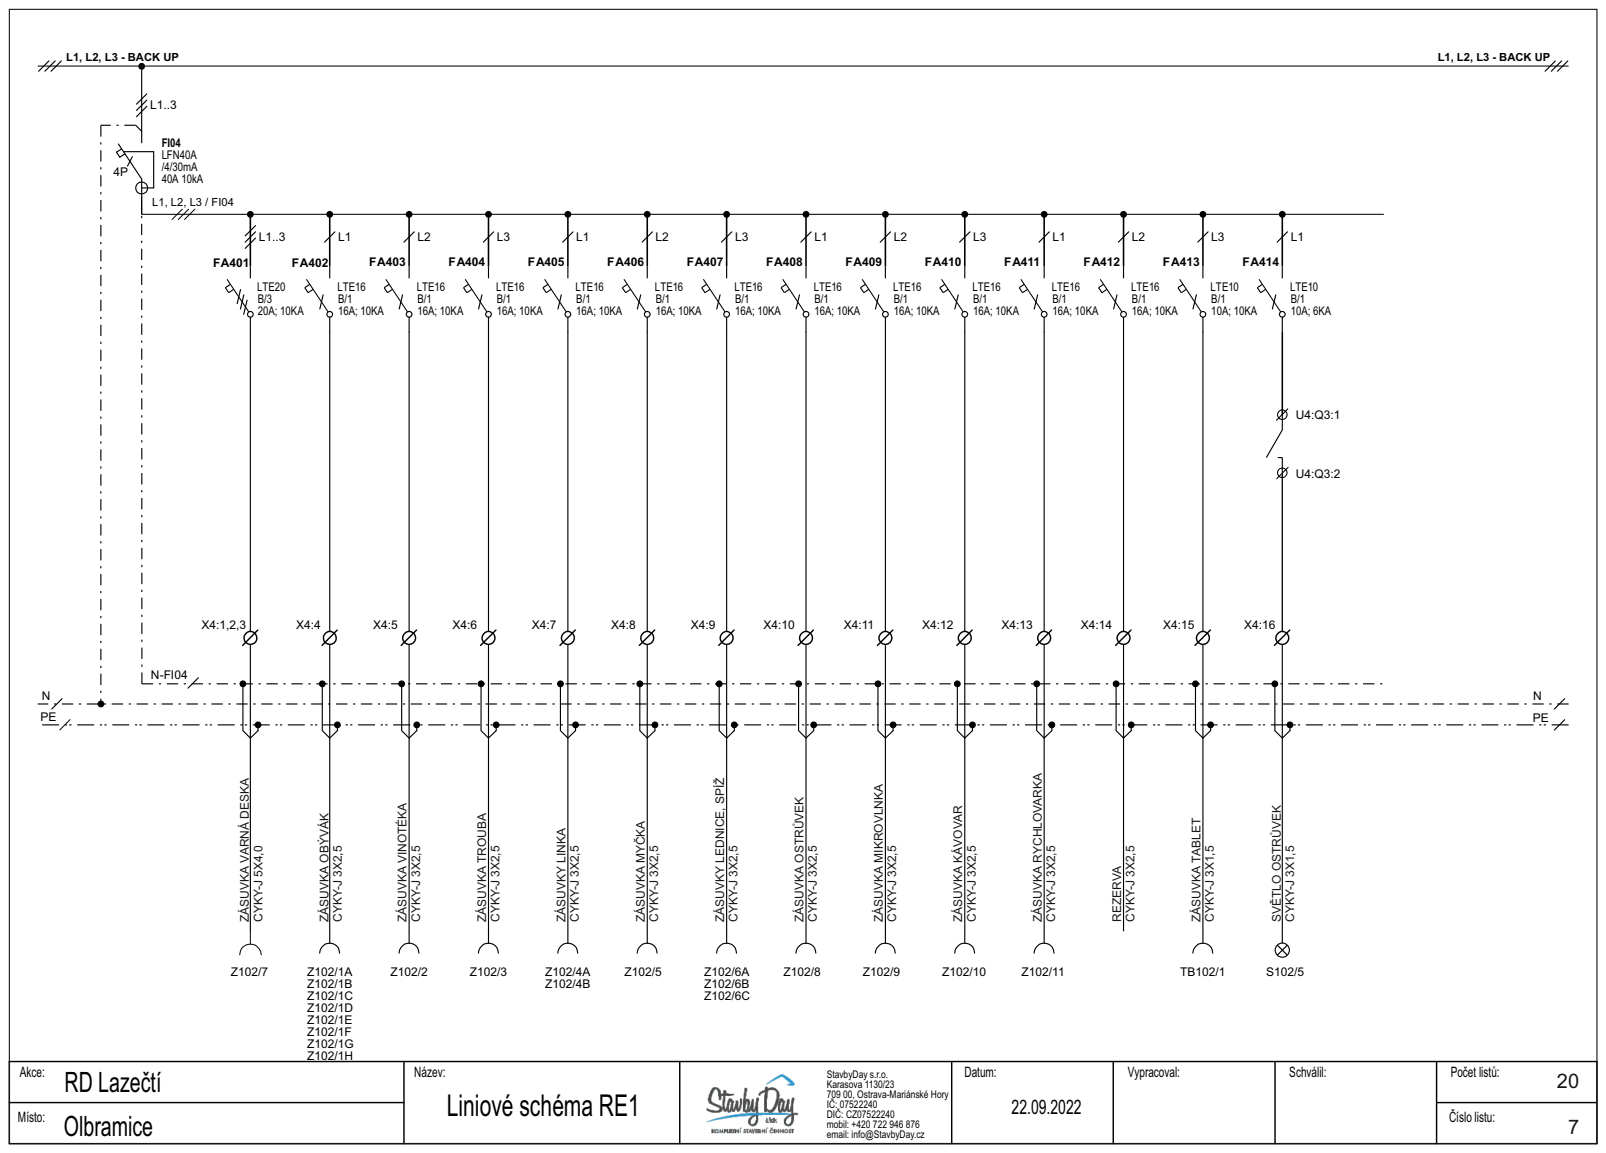
[picture p9: page 7]
FI04 LFN40A /4/30mA 40A 10kA 4P; ZÁSUVKA OBÝVÁK; CYKY-J 3X2,5; ZÁSUVKA TABLET; CYKY-J 3X1,5; ZÁSUVKA TROUBA; ZÁSUVKY LINKA; ZÁSUVKA MYČKA; ZÁSUVKA OSTRŮVEK; LTE16 B/1 16A; 10KA; ZÁSUVKA MIKROVLNKA; ZÁSUVKA KÁVOVAR; ZÁSUVKA RYCHLOVARKA; LTE10 B/1 10A; 10KA; LTE10 B/1 10A; 6KA; SVĚTLO OSTRŮVEK; LTE20 B/3 20A; 10KA; CYKY-J 5X4,0; REZERVA; L1, L2, L3 - BACK UP

ZÁSUVKY LEDNICE, SPÍŽ

Z102/2 ZÁSUVKA VINOTÉKA CYKY⁻J 3X²,5

# FA501ZÁSUVKY ZÁDVEŘÍ

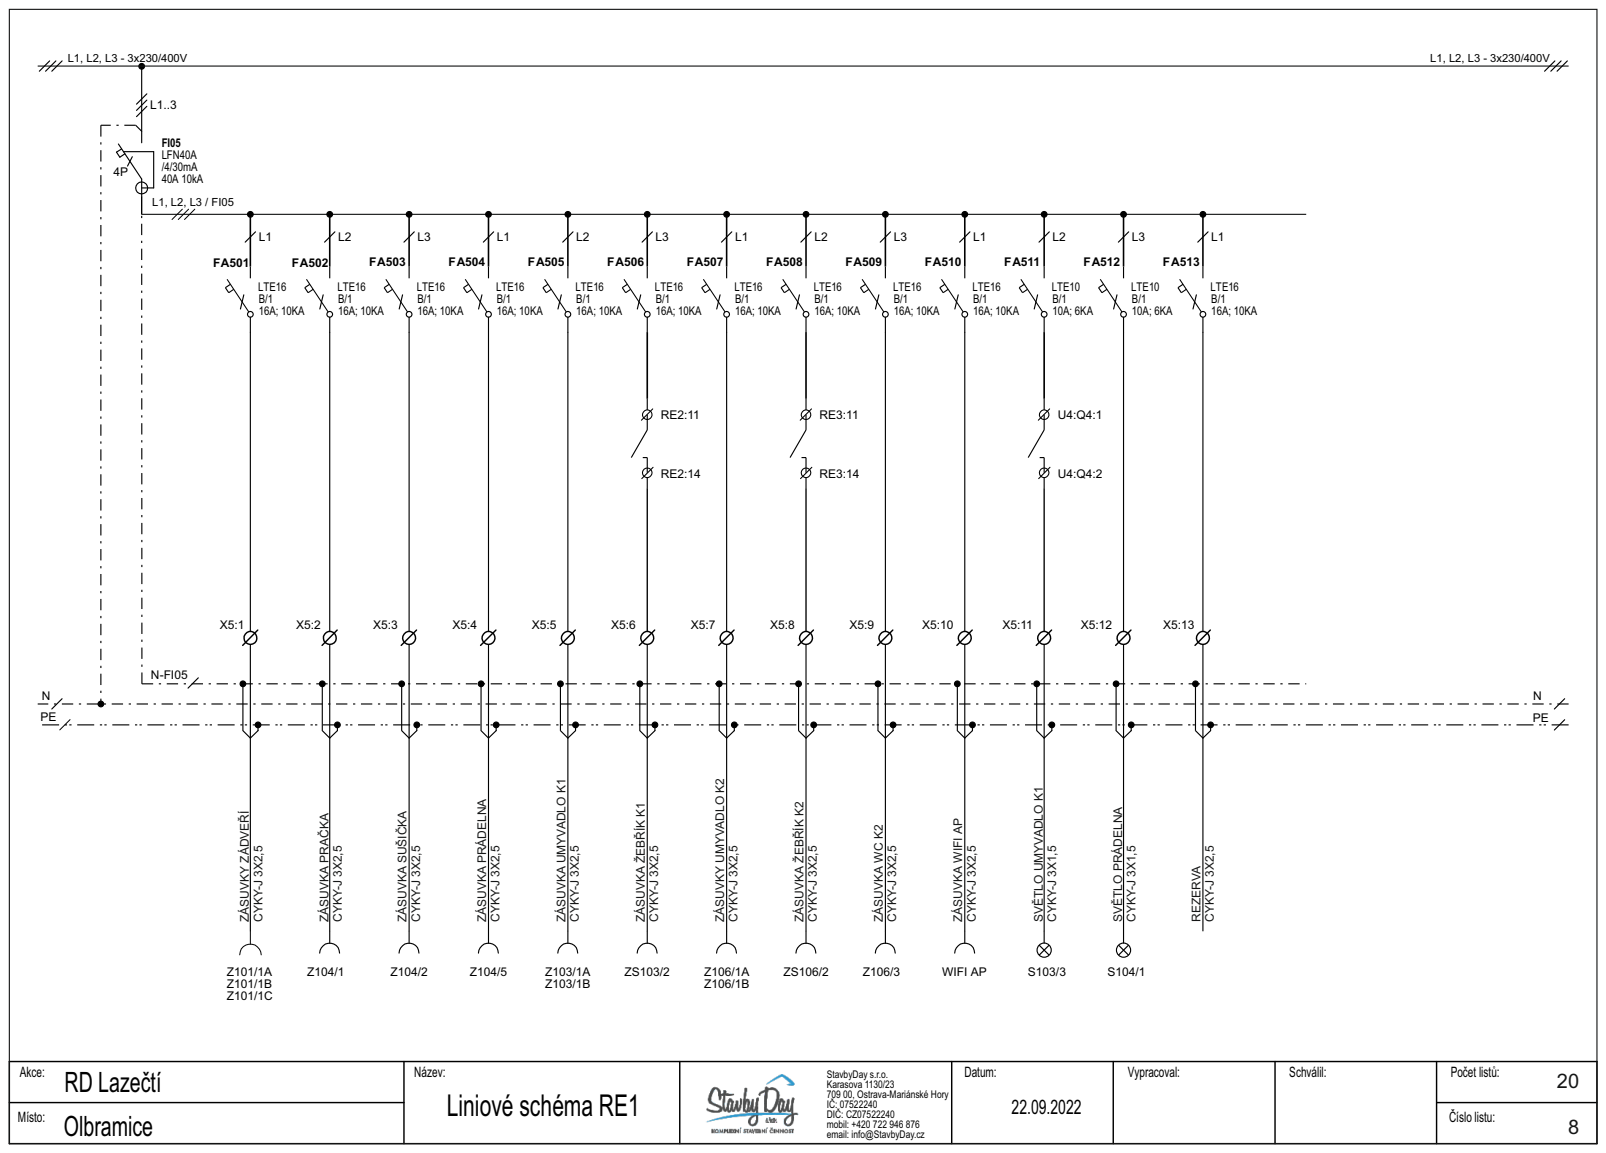
[picture p10: page 8]
FI05 LFN40A /4/30mA 40A 10kA 4P; ZÁSUVKA PRAČKA; CYKY-J 3X2,5; REZERVA; ZÁSUVKA UMYVADLO K1; ZÁSUVKA ŽEBŘÍK K1; ZÁSUVKY UMYVADLO K2; ZÁSUVKA ŽEBŘÍK K2; LTE16 B/1 16A; 10KA; ZÁSUVKA WC K2; WIFI AP; LTE10 B/1 10A; 6KA; SVĚTLO PRÁDELNA; CYKY-J 3X1,5; SVĚTLO UMYVADLO K1

ZÁSUVKA PRÁDELNA
Z104/2 ZÁSUVKA SUŠIČKA CYKY⁻J 3X²,5

ZÁSUVKA WIFI AP

# FA601ZÁSUVKA CHODBA

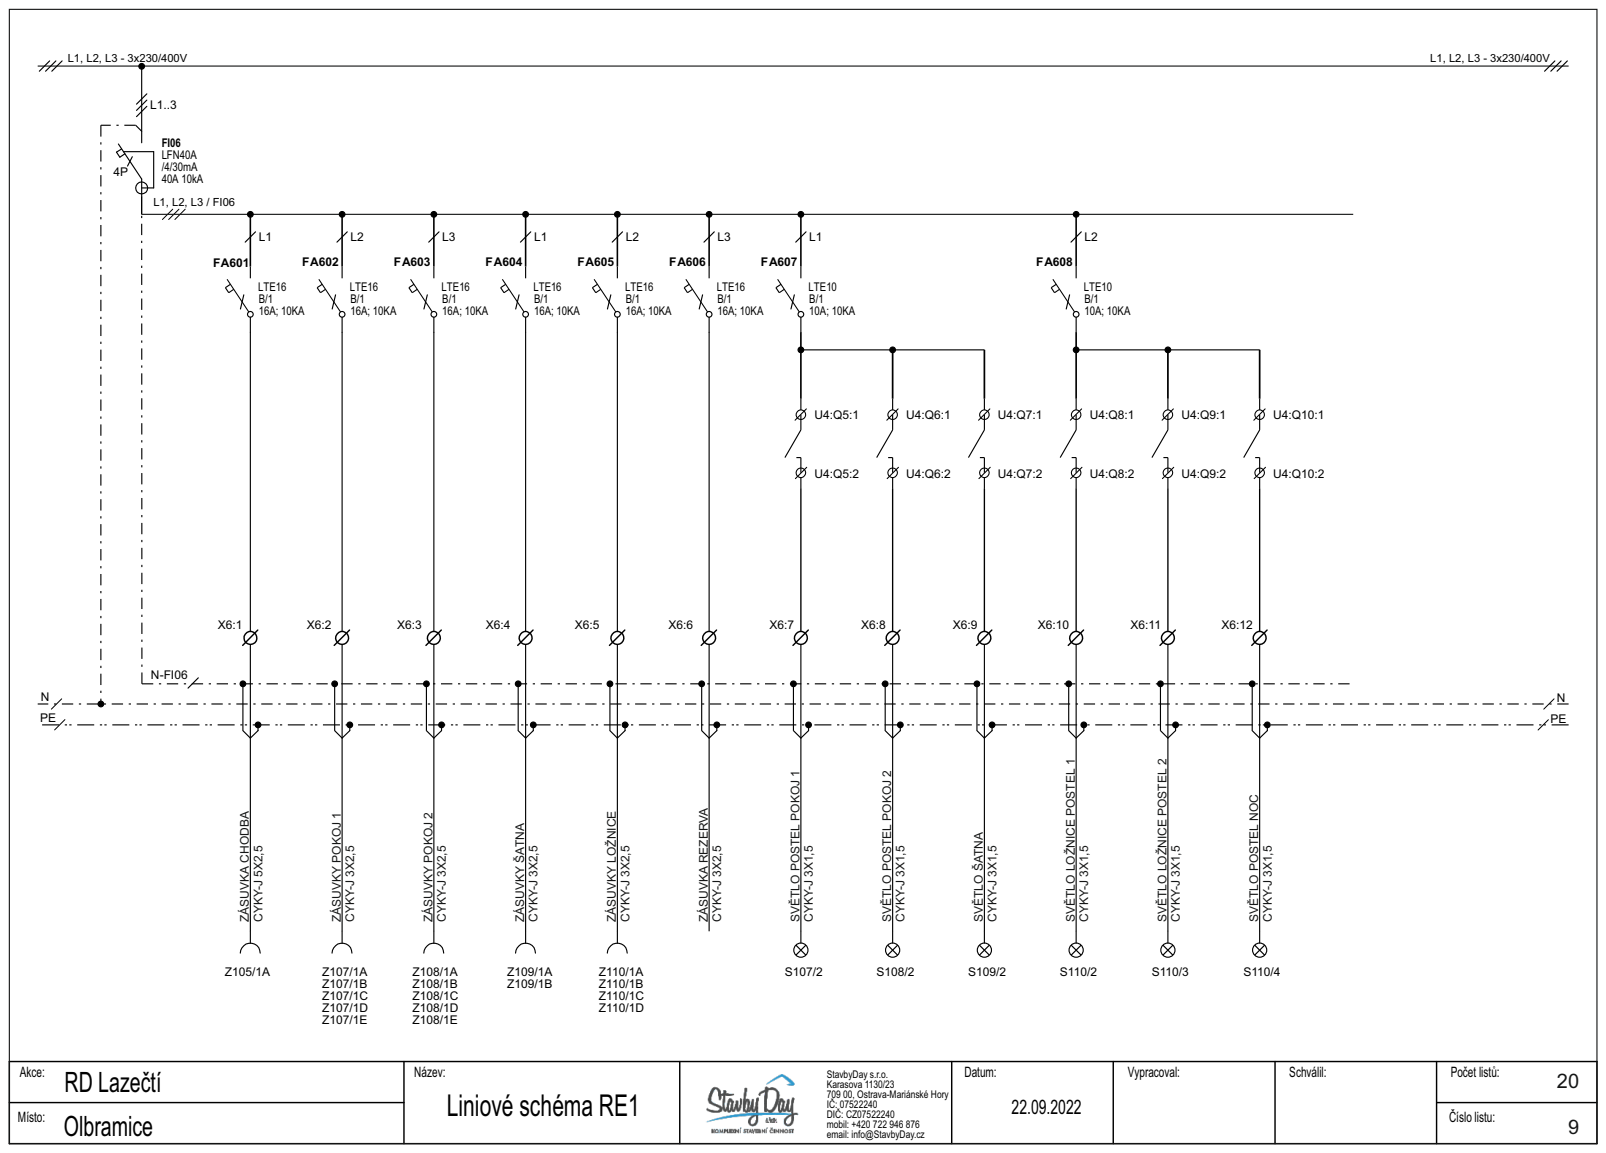
[picture p11: page 9]
FI06 LFN40A /4/30mA 40A 10kA 4P; ZÁSUVKY POKOJ 2; CYKY-J 3X2,5; ZÁSUVKY ŠATNA; CYKY-J 5X2,5; ZÁSUVKY POKOJ 1; ZÁSUVKY LOŽNICE; ZÁSUVKA REZERVA; LTE16 B/1 16A; 10KA; LTE10 B/1 10A; 10KA; CYKY-J 3X1,5; SVĚTLO ŠATNA

SVĚTLO POSTEL POKOJ 1

SVĚTLO POSTEL POKOJ 2

SVĚTLO LOŽNICE POSTEL 1

SVĚTLO LOŽNICE POSTEL 2

SVĚTLO POSTEL NOC

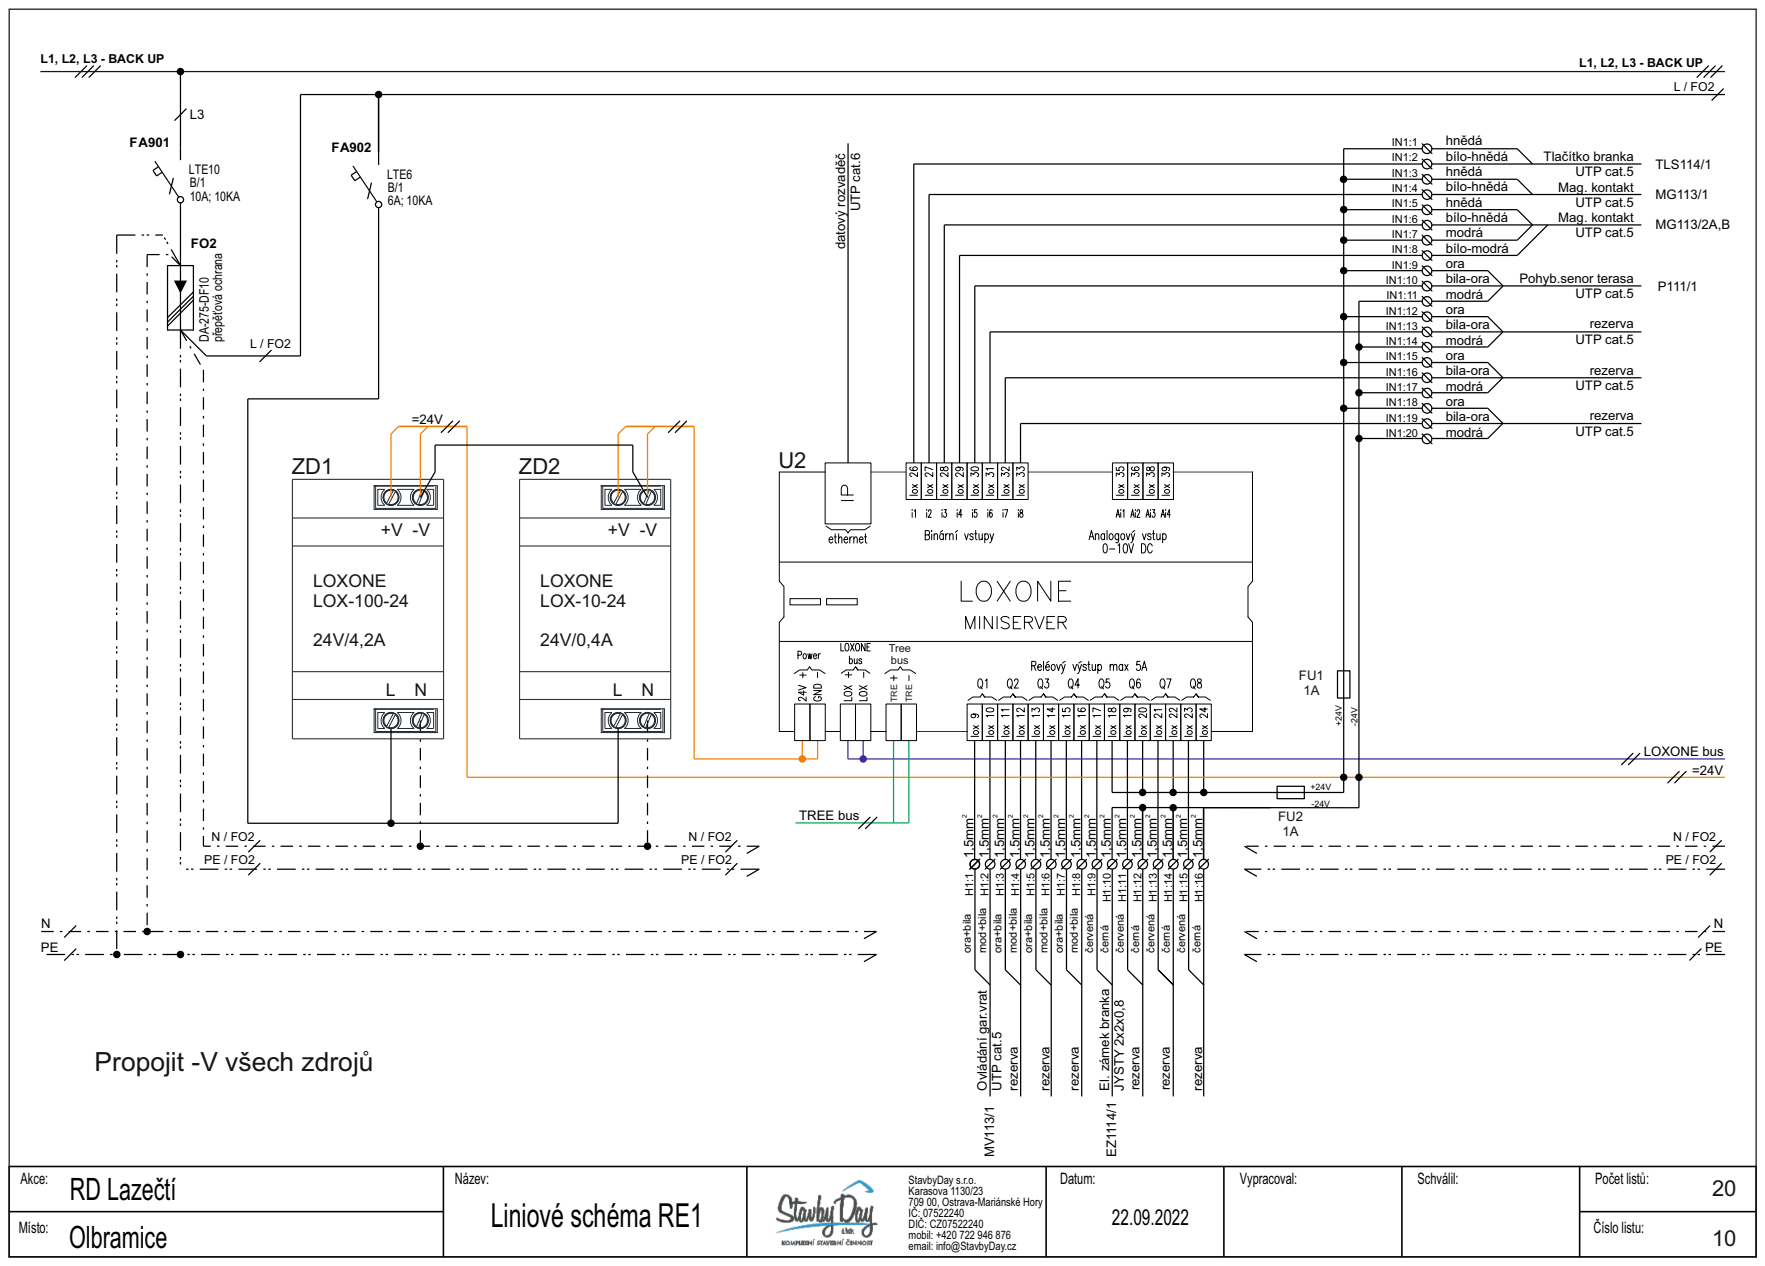
[picture p12: page 10]
LOXONE bus; LTE10 B/1 10A; 10KA; UTP cat.5; rezerva; přepěťová ochrana; TLS114/1; Tlačítko branka UTP cat.5; rezerva UTP cat.5; hnědá bílo-hnědá hnědá bílo-hnědá hnědá bílo-hnědá modrá bílo-modrá ora bila-ora modrá ora bila-ora modrá ora bila-ora modrá ora bila-ora modrá; Tree; busTRE TRE; ora+bila; mod+bila; červená; černá; datový rozvaděč; UTP cat.6; TREE bus; Mag. kontakt UTP cat.5; JYSTY 2x2x0,8 EZ1114/1; LOXONE LOX-100-24; L1, L2, L3 - BACK UP; LOXONE LOX-10-24; Mag. kontakt; LTE6 B/1 6A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

Pohyb.senor terasa

Ovládání gar.vrat

El. zámek branka

Propojit -V všech zdrojů

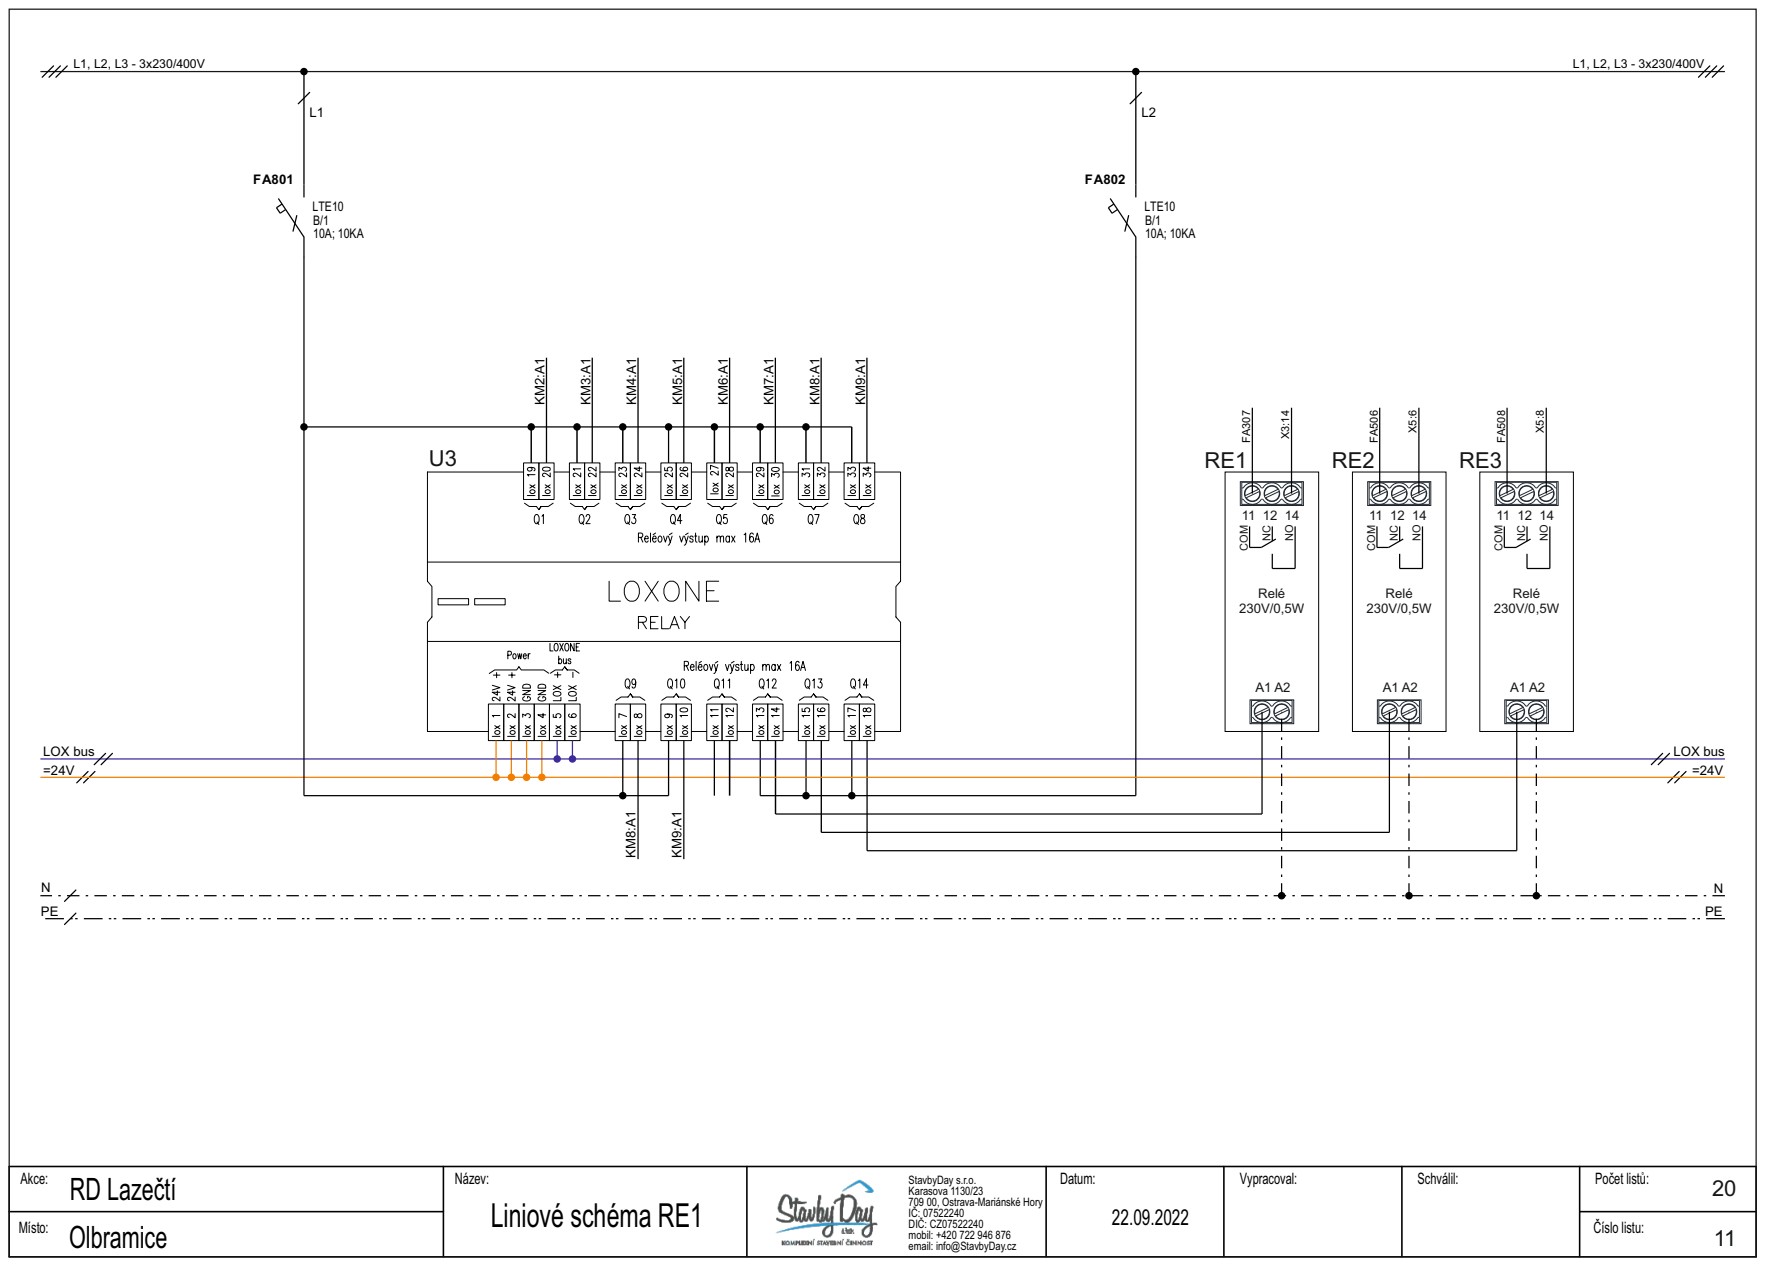
[picture p13: page 11]
LTE10 B/1 10A; 10KA; LOX bus; Relé 230V/0,5W; COM; RE1 FA³⁰⁷; RE2 FA⁵⁰⁶; RE3 FA⁵⁰⁸

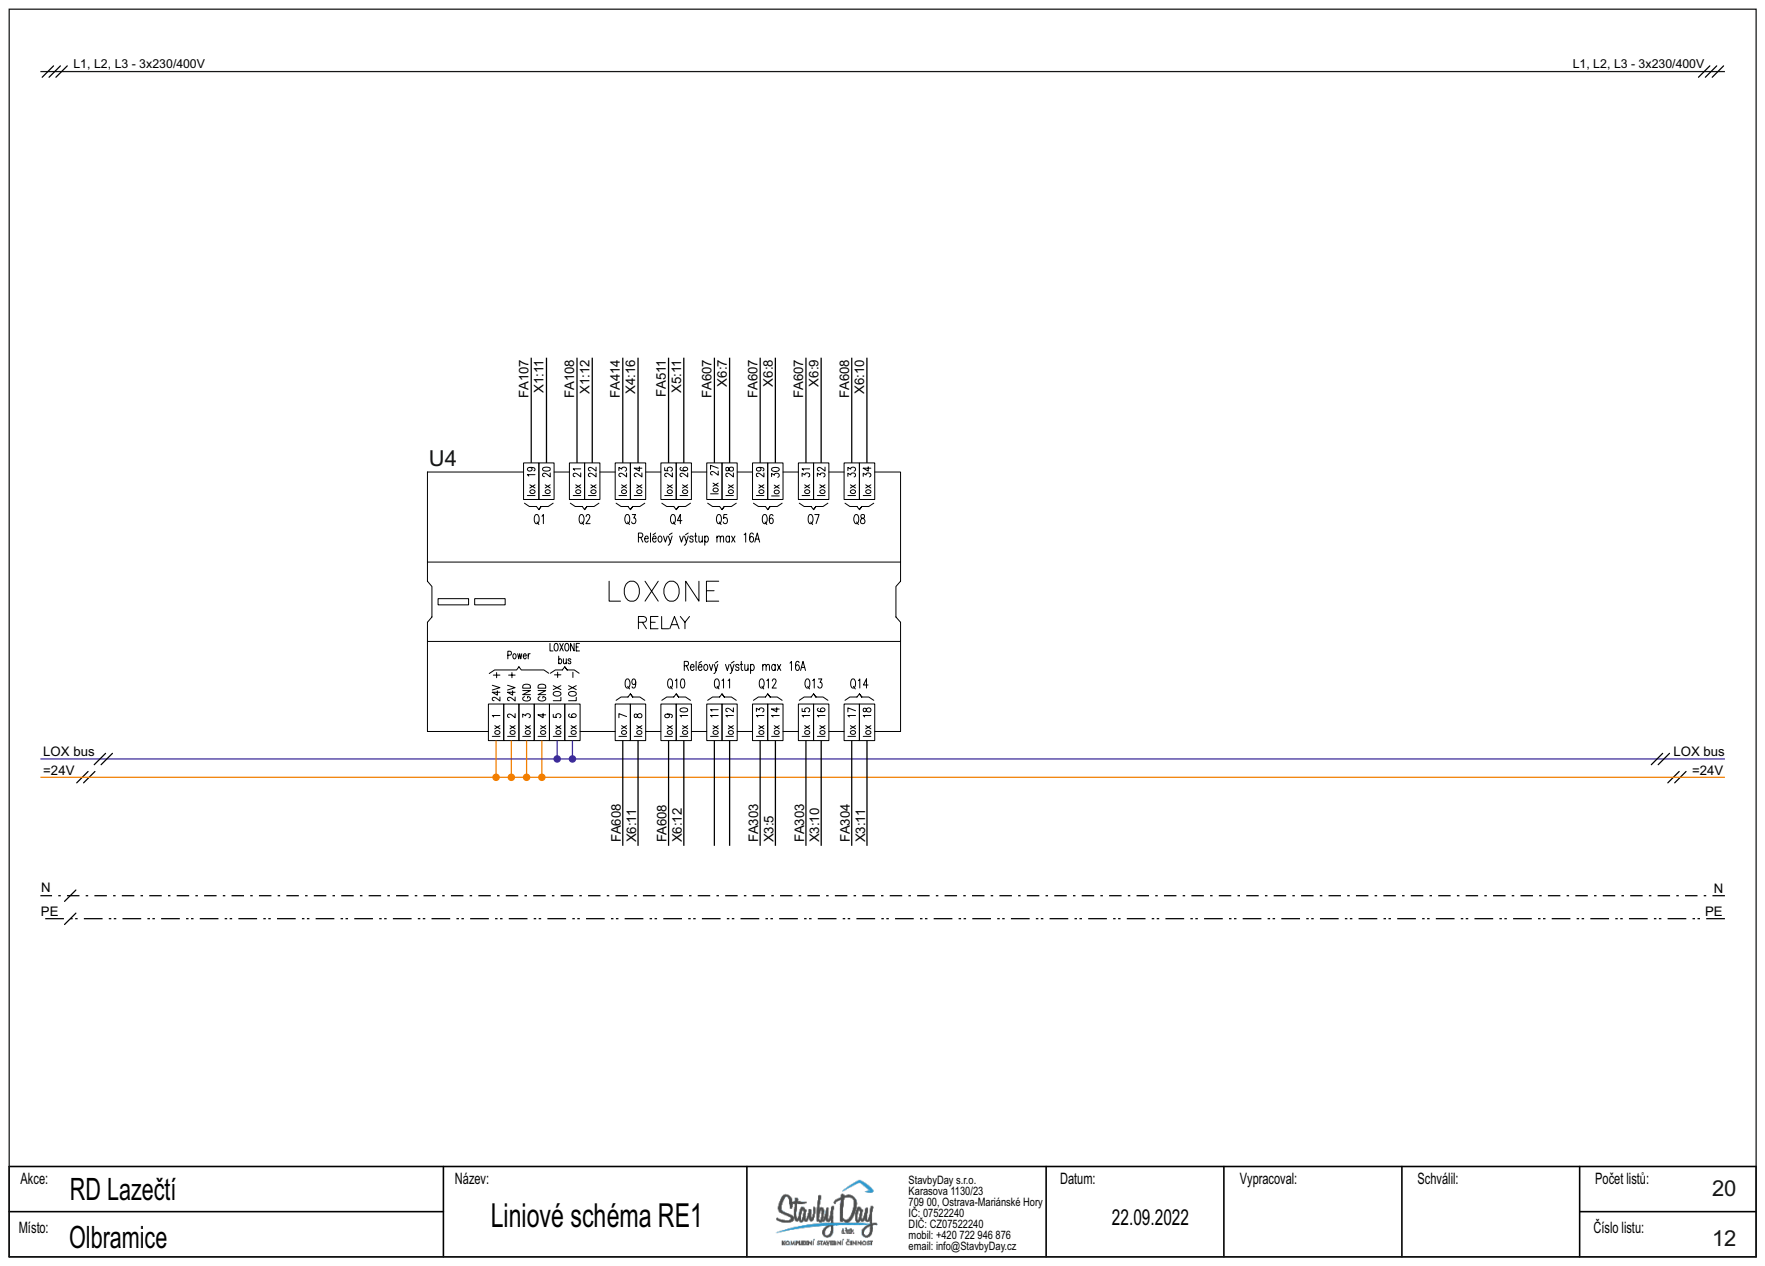
[picture p14: page 12]
LOX bus

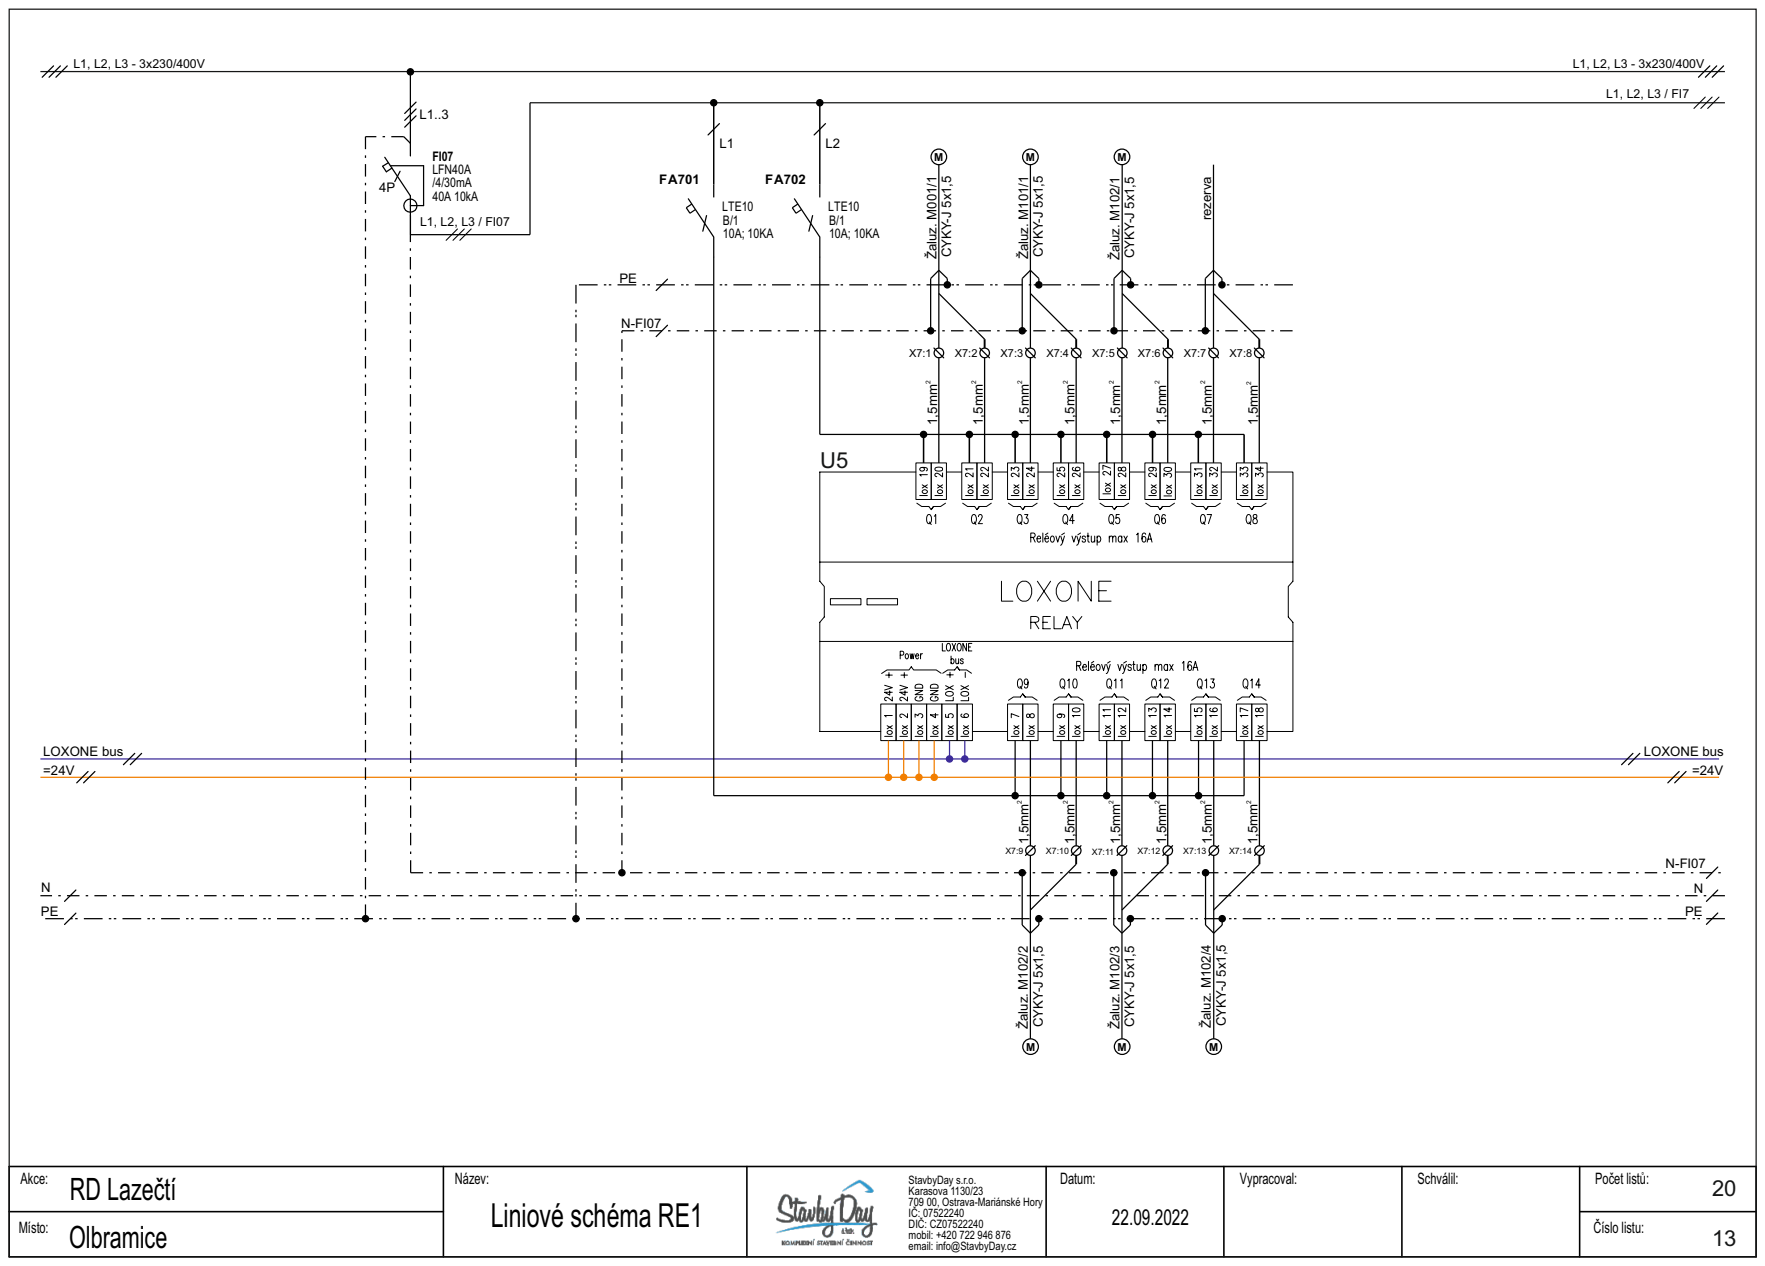
[picture p15: page 13]
Žaluz. M102/1; CYKY-J 5x1,5; rezerva; Žaluz. M102/3; Žaluz. M101/1; Žaluz. M001/1; Žaluz. M102/4; LTE10 B/1 10A; 10KA; LOXONE bus; X7:8 Žaluz. M¹⁰²/2; CYKY⁻J 5x1,5; FI07 LFN40A /4/30mA 40A 10kA 4P

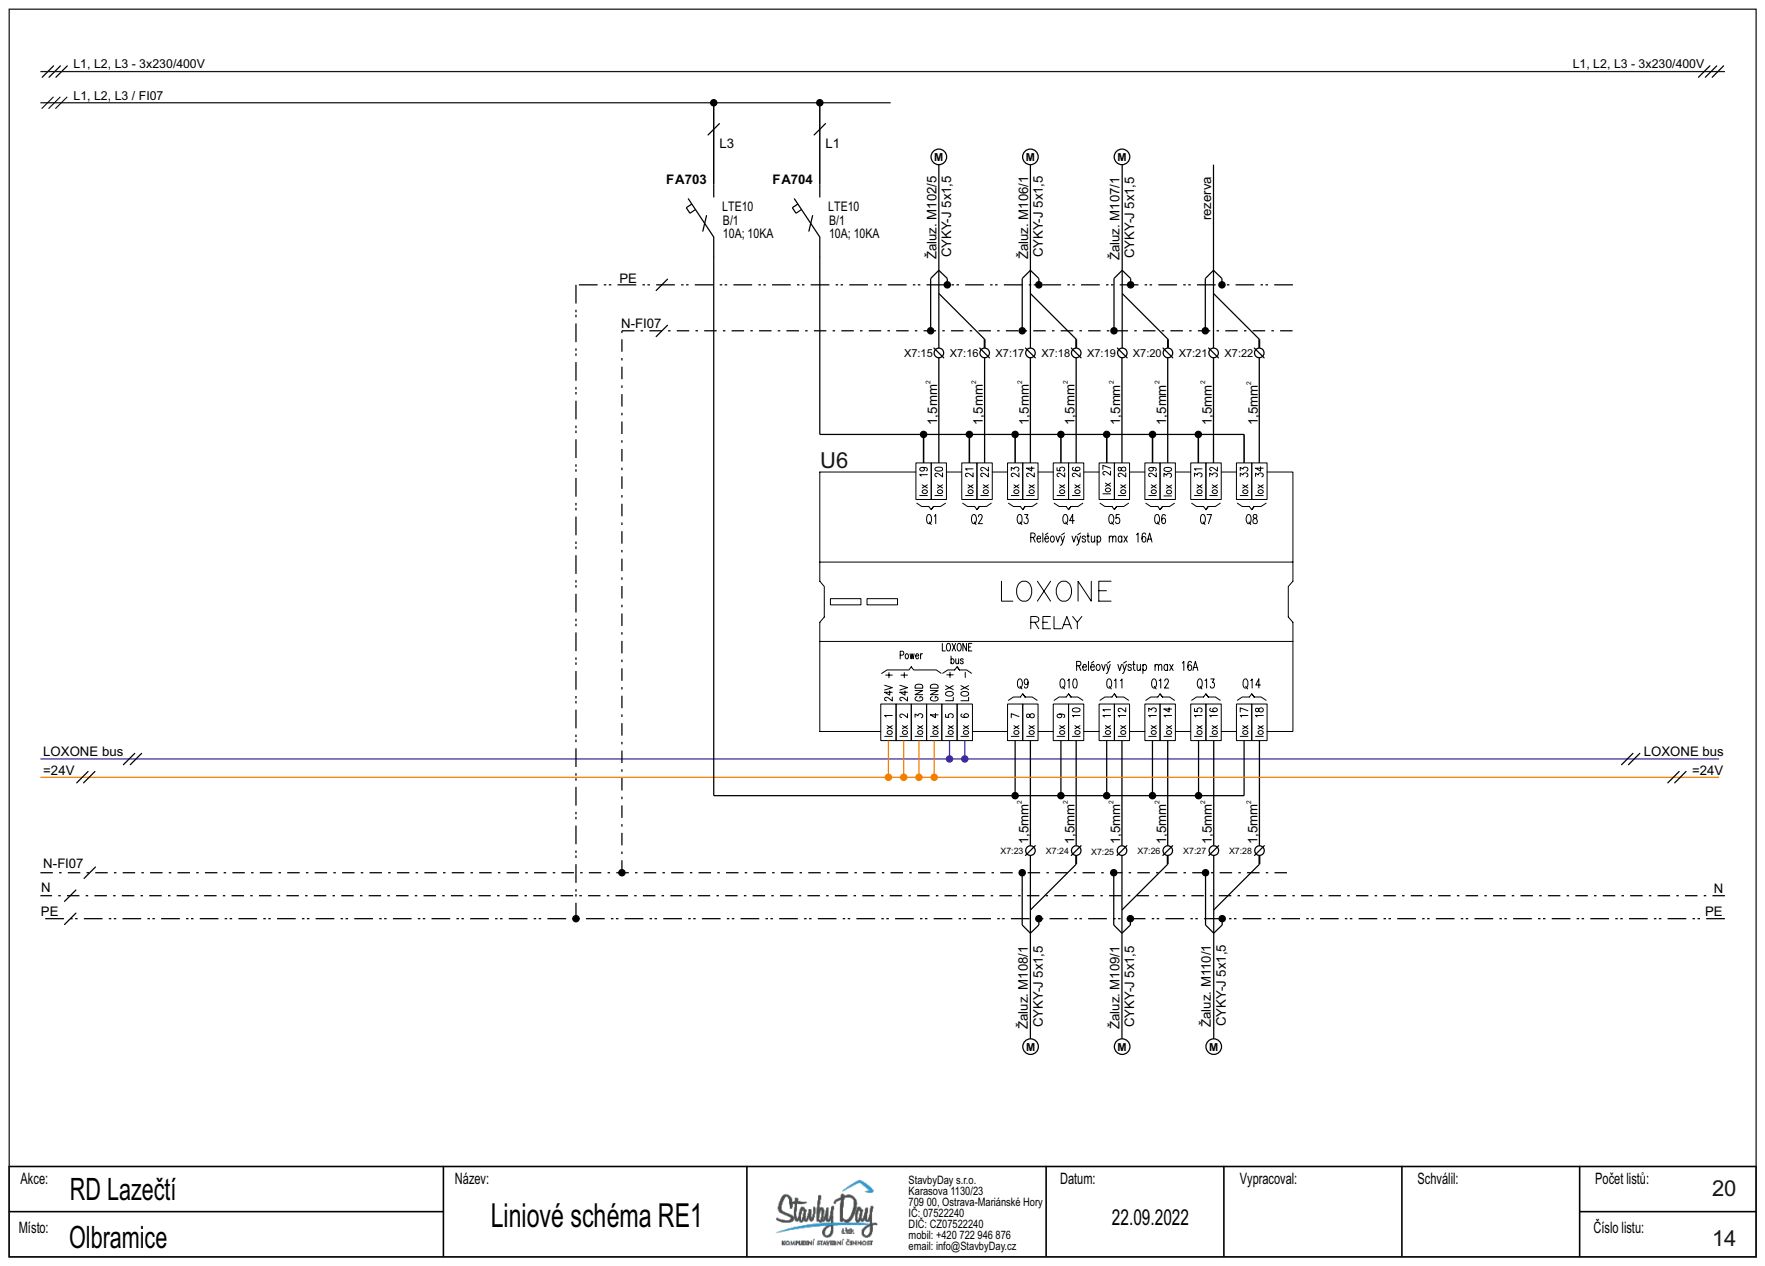
[picture p16: page 14]
Žaluz. M107/1; CYKY-J 5x1,5; rezerva; Žaluz. M109/1; Žaluz. M106/1; Žaluz. M102/5; Žaluz. M110/1; LTE10 B/1 10A; 10KA; LOXONE bus; X7:22 Žaluz. M¹⁰⁸/1; CYKY⁻J 5x1,5

FOTOVOLTAIKA K¹:1 | K¹:2 | K¹:3

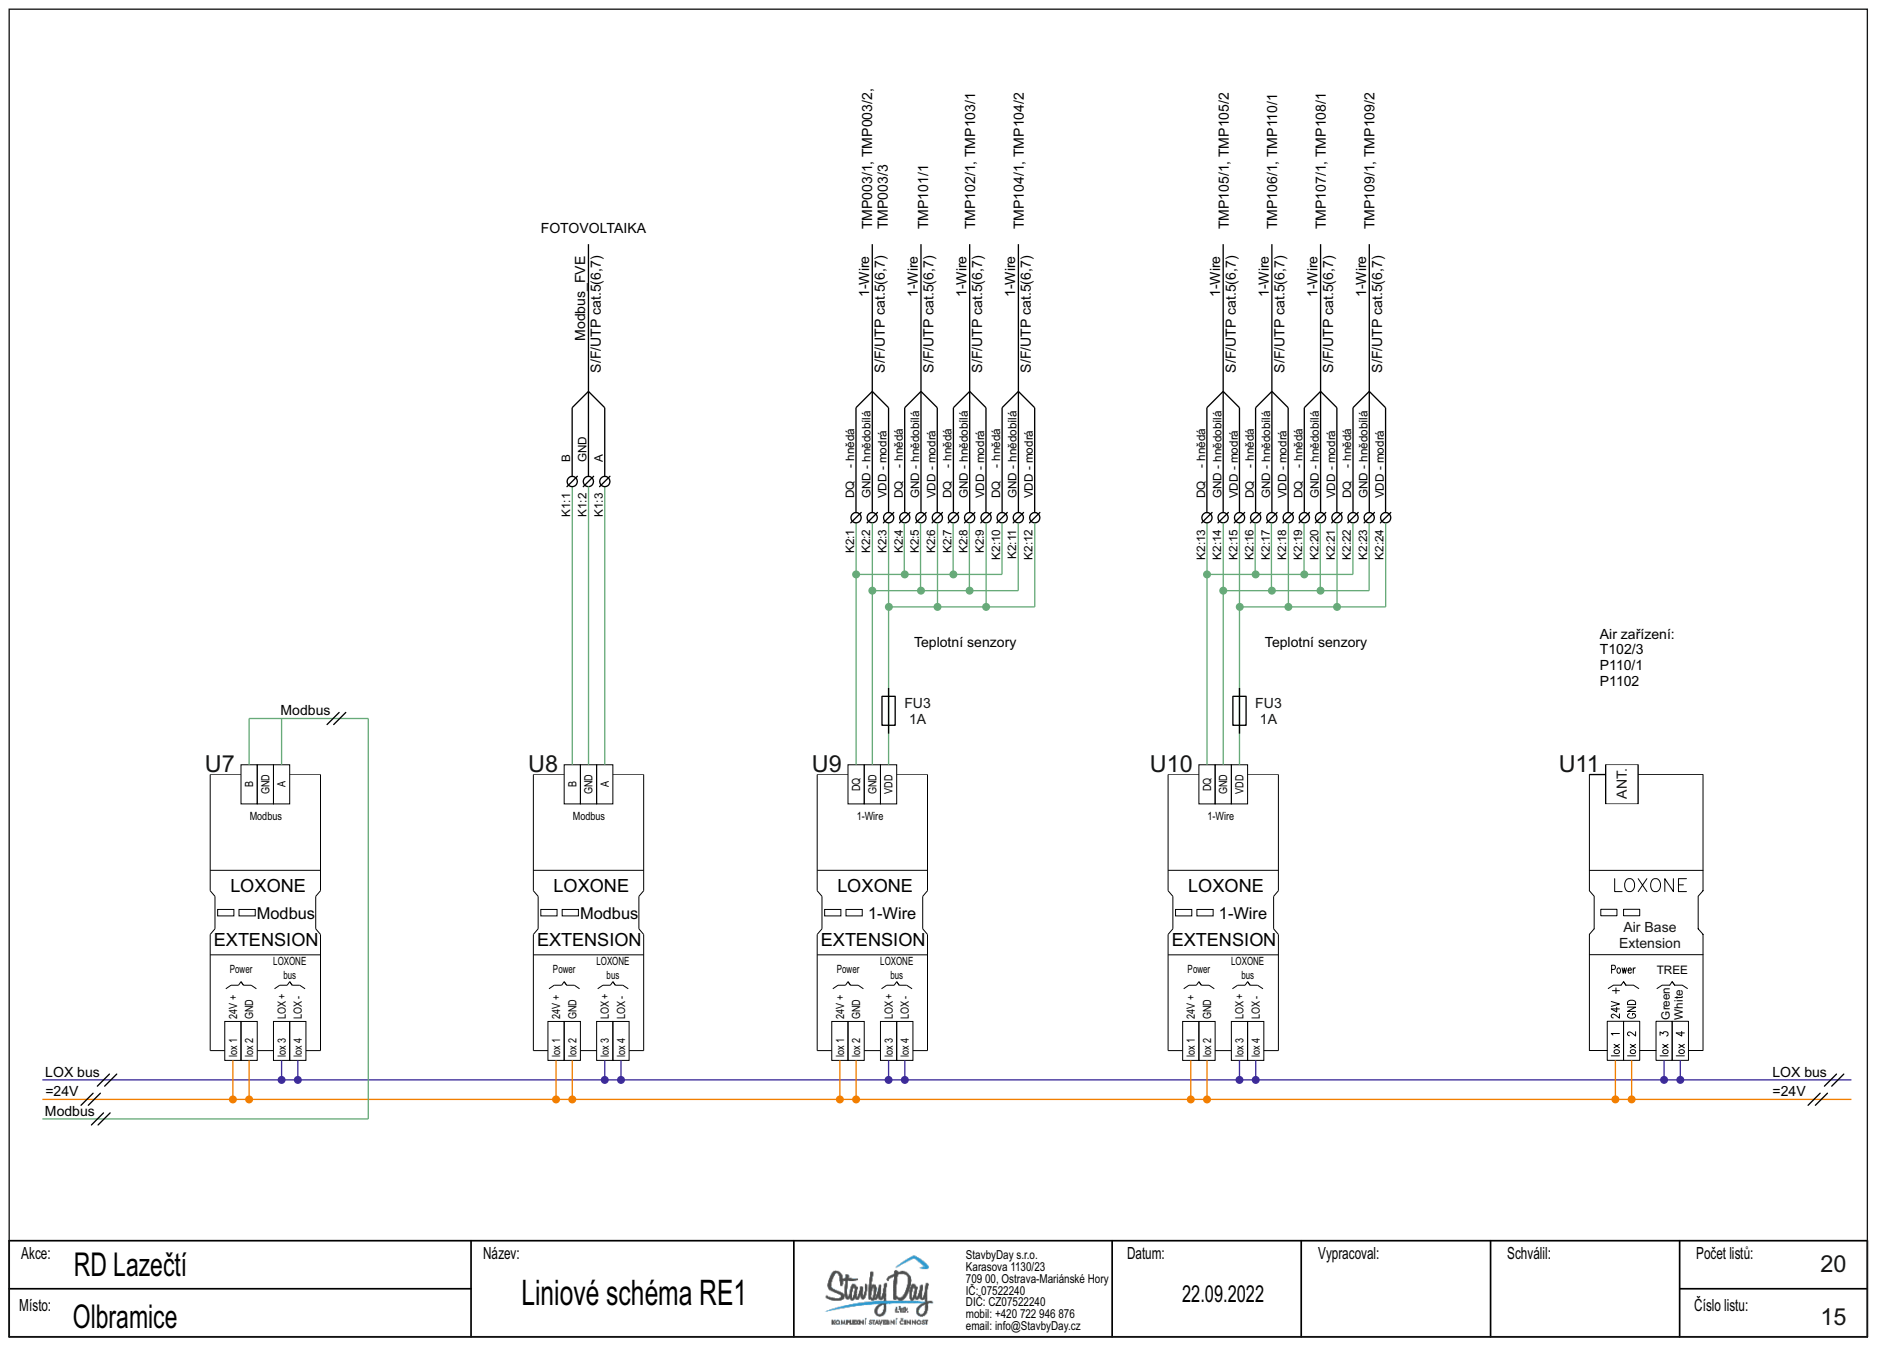
[picture p17: page 15]
LOX bus; lox 1; lox 2 B; EXTENSION; Modbus; lox 3; lox 4; LOXONE bus; GND; Power; LOX +; LOX -; LOXONE; Air Base; Extension ANT; Modbus_FVE; S/F/UTP cat.5(6,7); lox 2 DQ; 1-Wire; 1-WireGND; VDD; DQ - hnědá; GND - hnědobílá; VDD - modrá; Teplotní senzory; TMP003/1, TMP003/2,; TMP003/3; TMP101/1; TMP102/1, TMP103/1; TMP104/1, TMP104/2; TMP105/1, TMP105/2; TMP106/1, TMP110/1; TMP107/1, TMP108/1; TMP109/1, TMP109/2; Air zařízení: T102/3 P110/1 P1102

TREE Green White

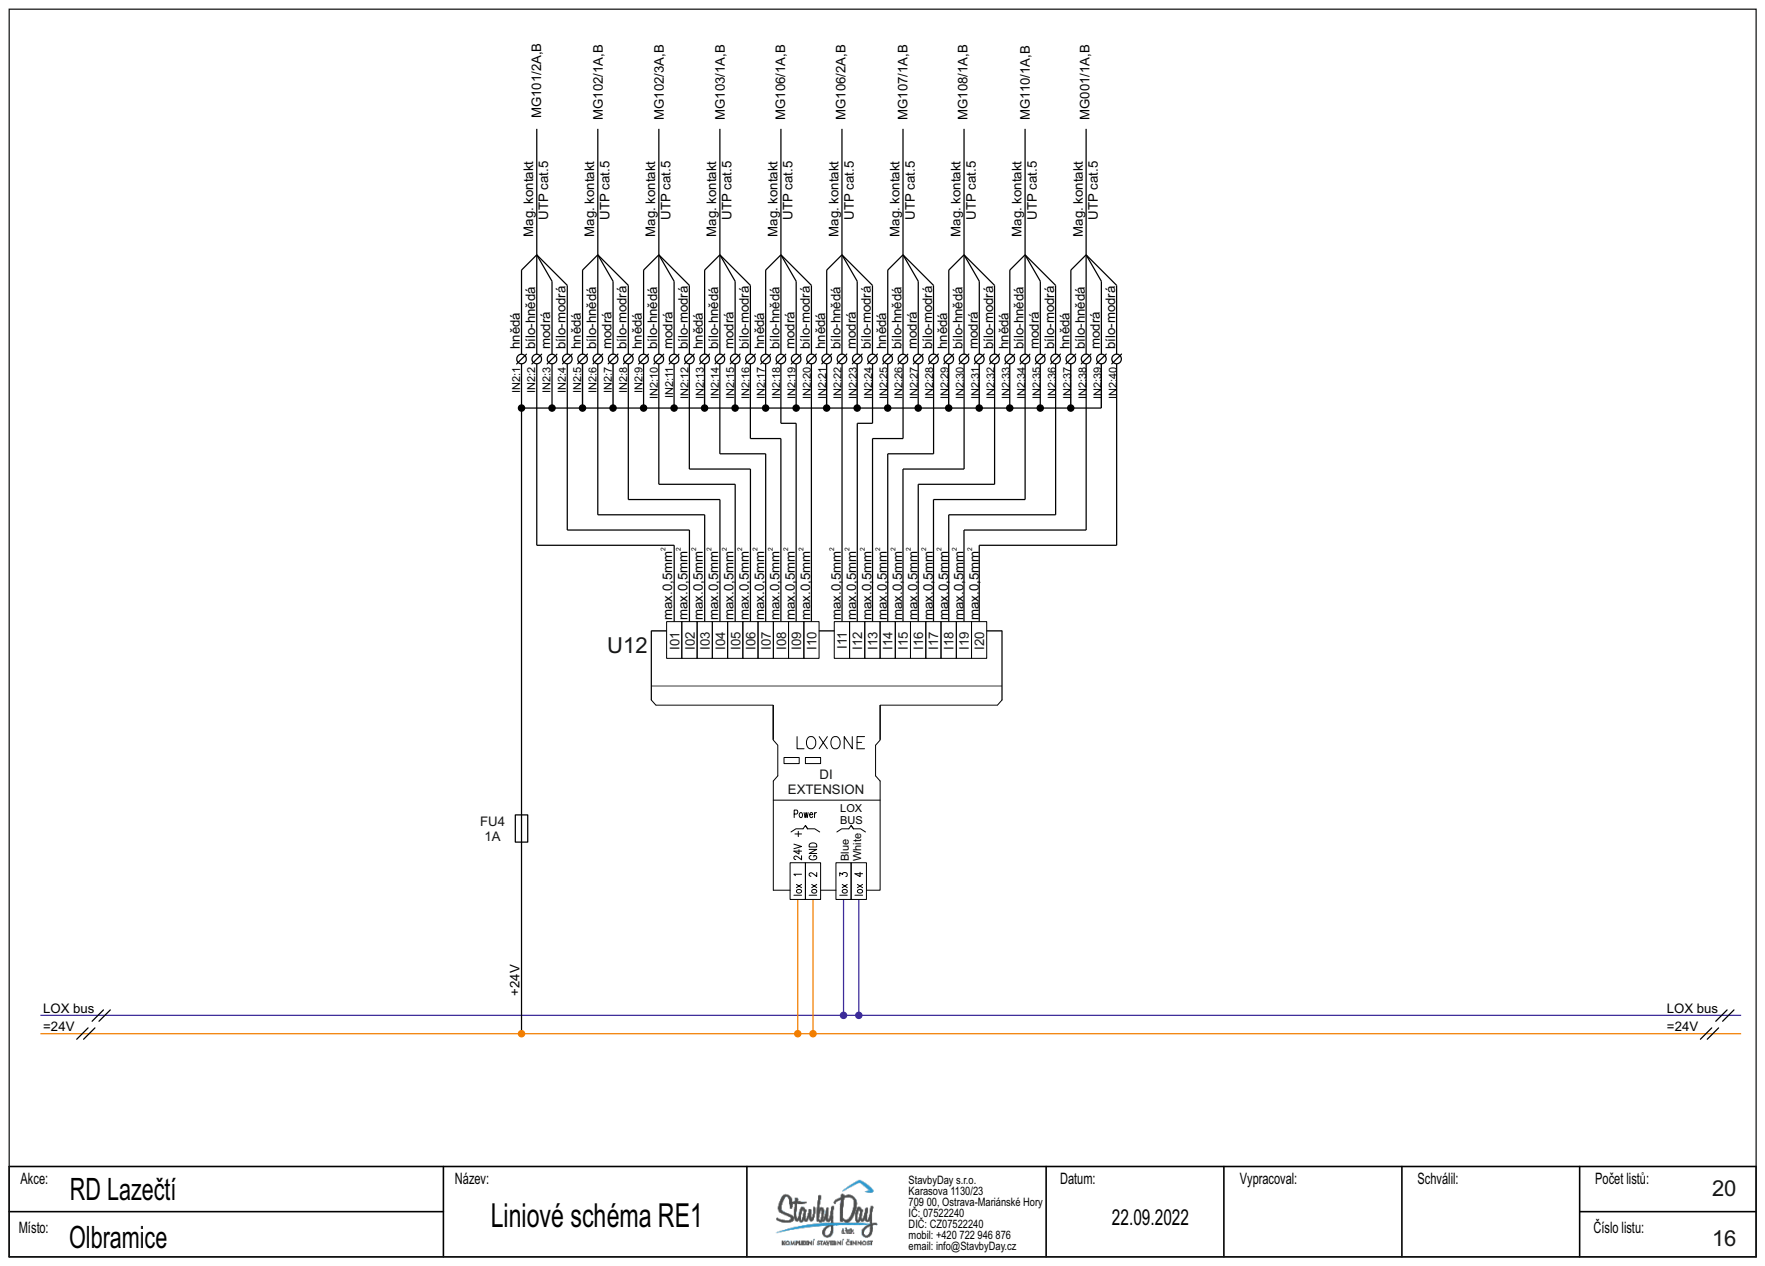
[picture p18: page 16]
LOX bus; Mag. kontakt; UTP cat.5; 2 max.0,5mm; LOX BUSBlue White; DI EXTENSION; +24V hnědá; bílo-hnědá; modrá; bílo-modrá; hnědá

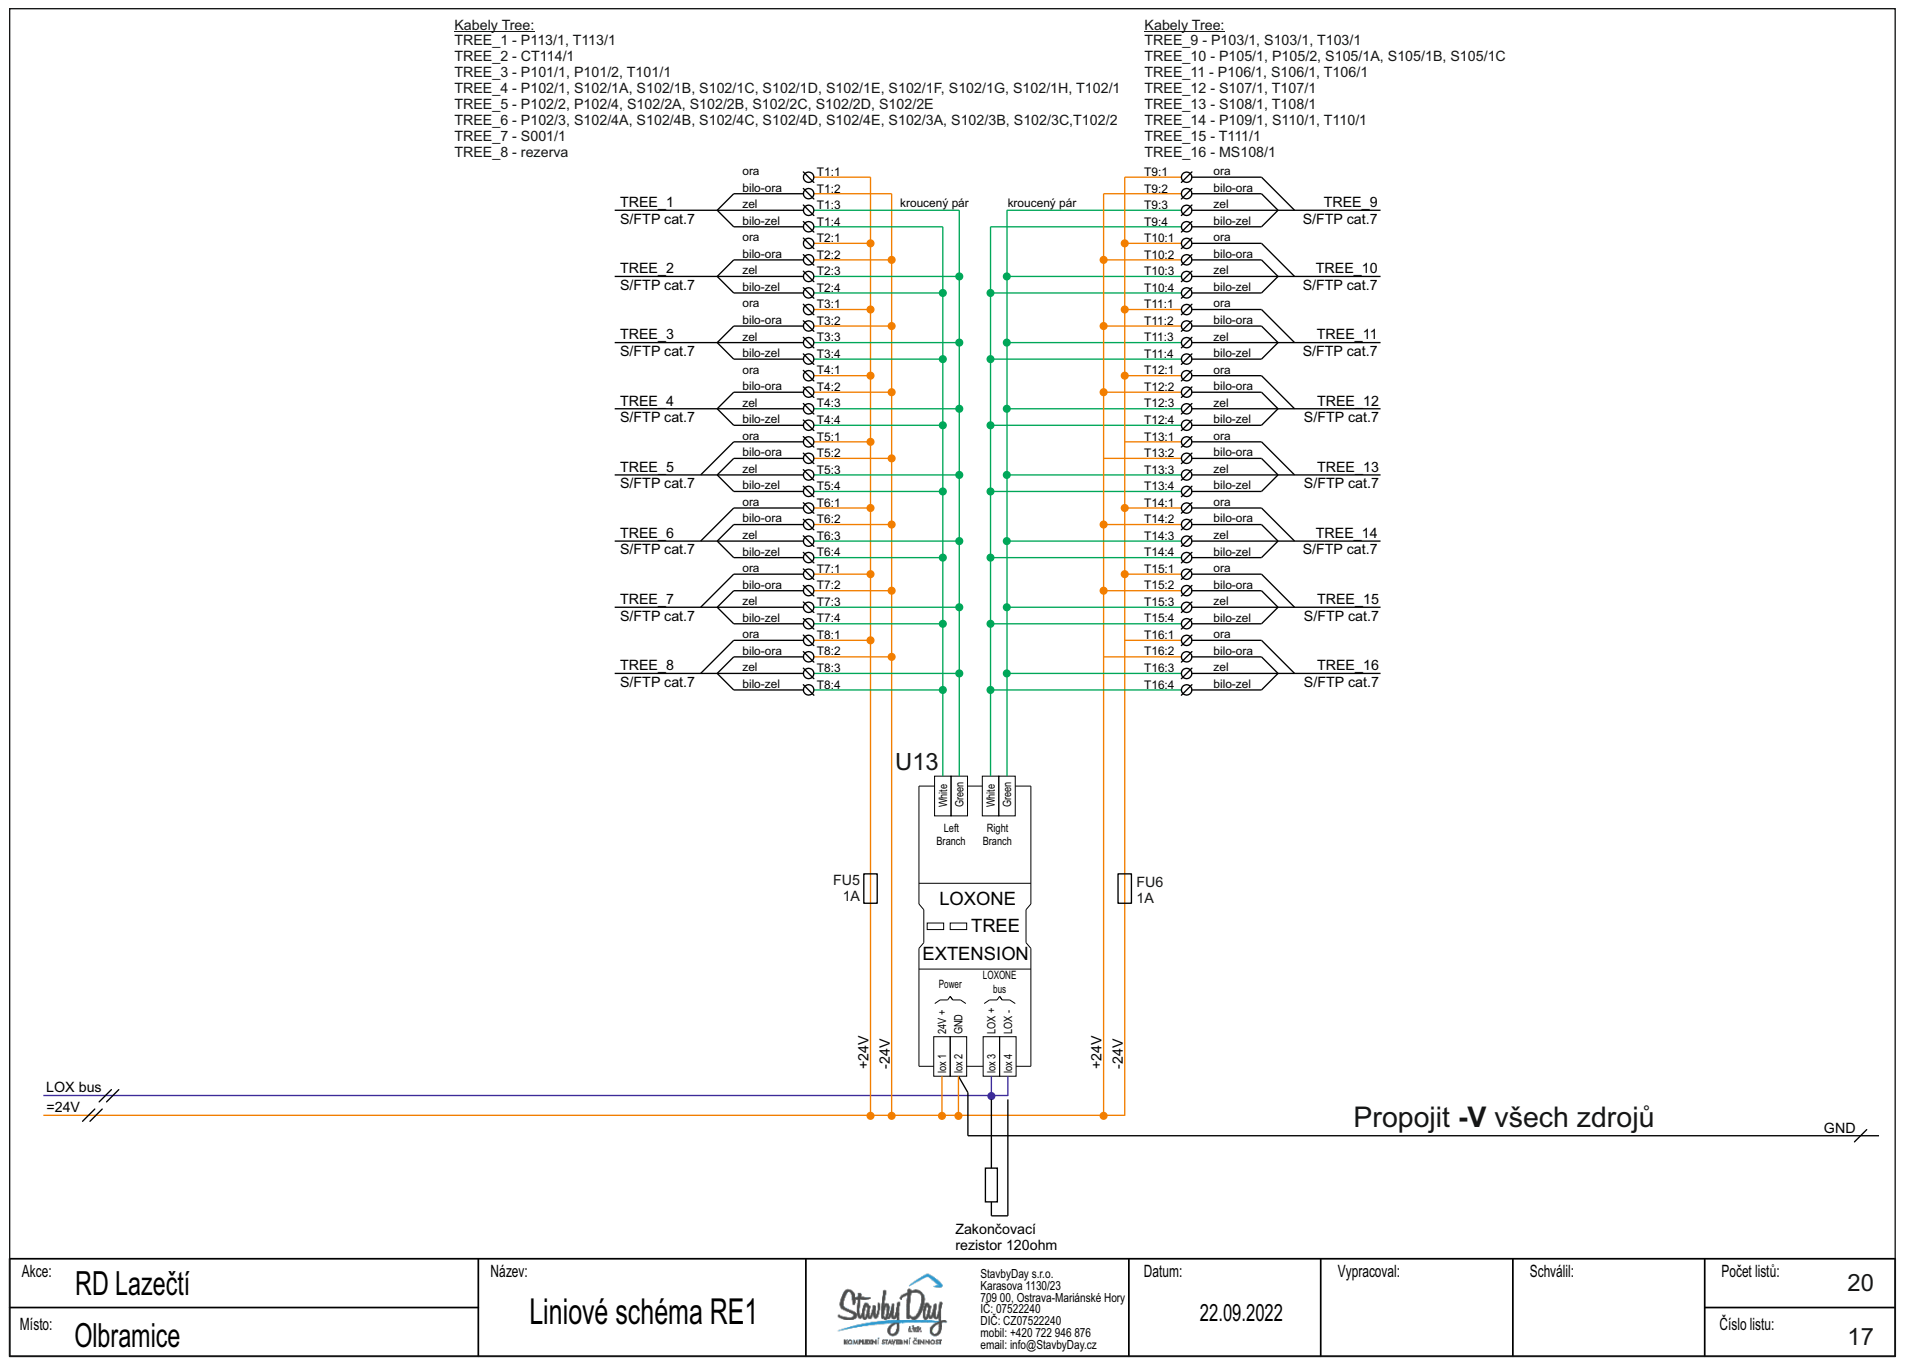
[picture p19: page 17]
LOX bus; Propojit -V všech zdrojů; GND; lox 1; lox 2; White; Green; EXTENSION; TREE; lox 3; lox 4; LOXONE bus; Power; LOX +; LOX -; Left; Branch; Right Branch; LOXONE; TREE_1 S/FTP cat.7; TREE_2 S/FTP cat.7; TREE_3 S/FTP cat.7; TREE_9 S/FTP cat.7; TREE_10 S/FTP cat.7; TREE_11 S/FTP cat.7; TREE_12 S/FTP cat.7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

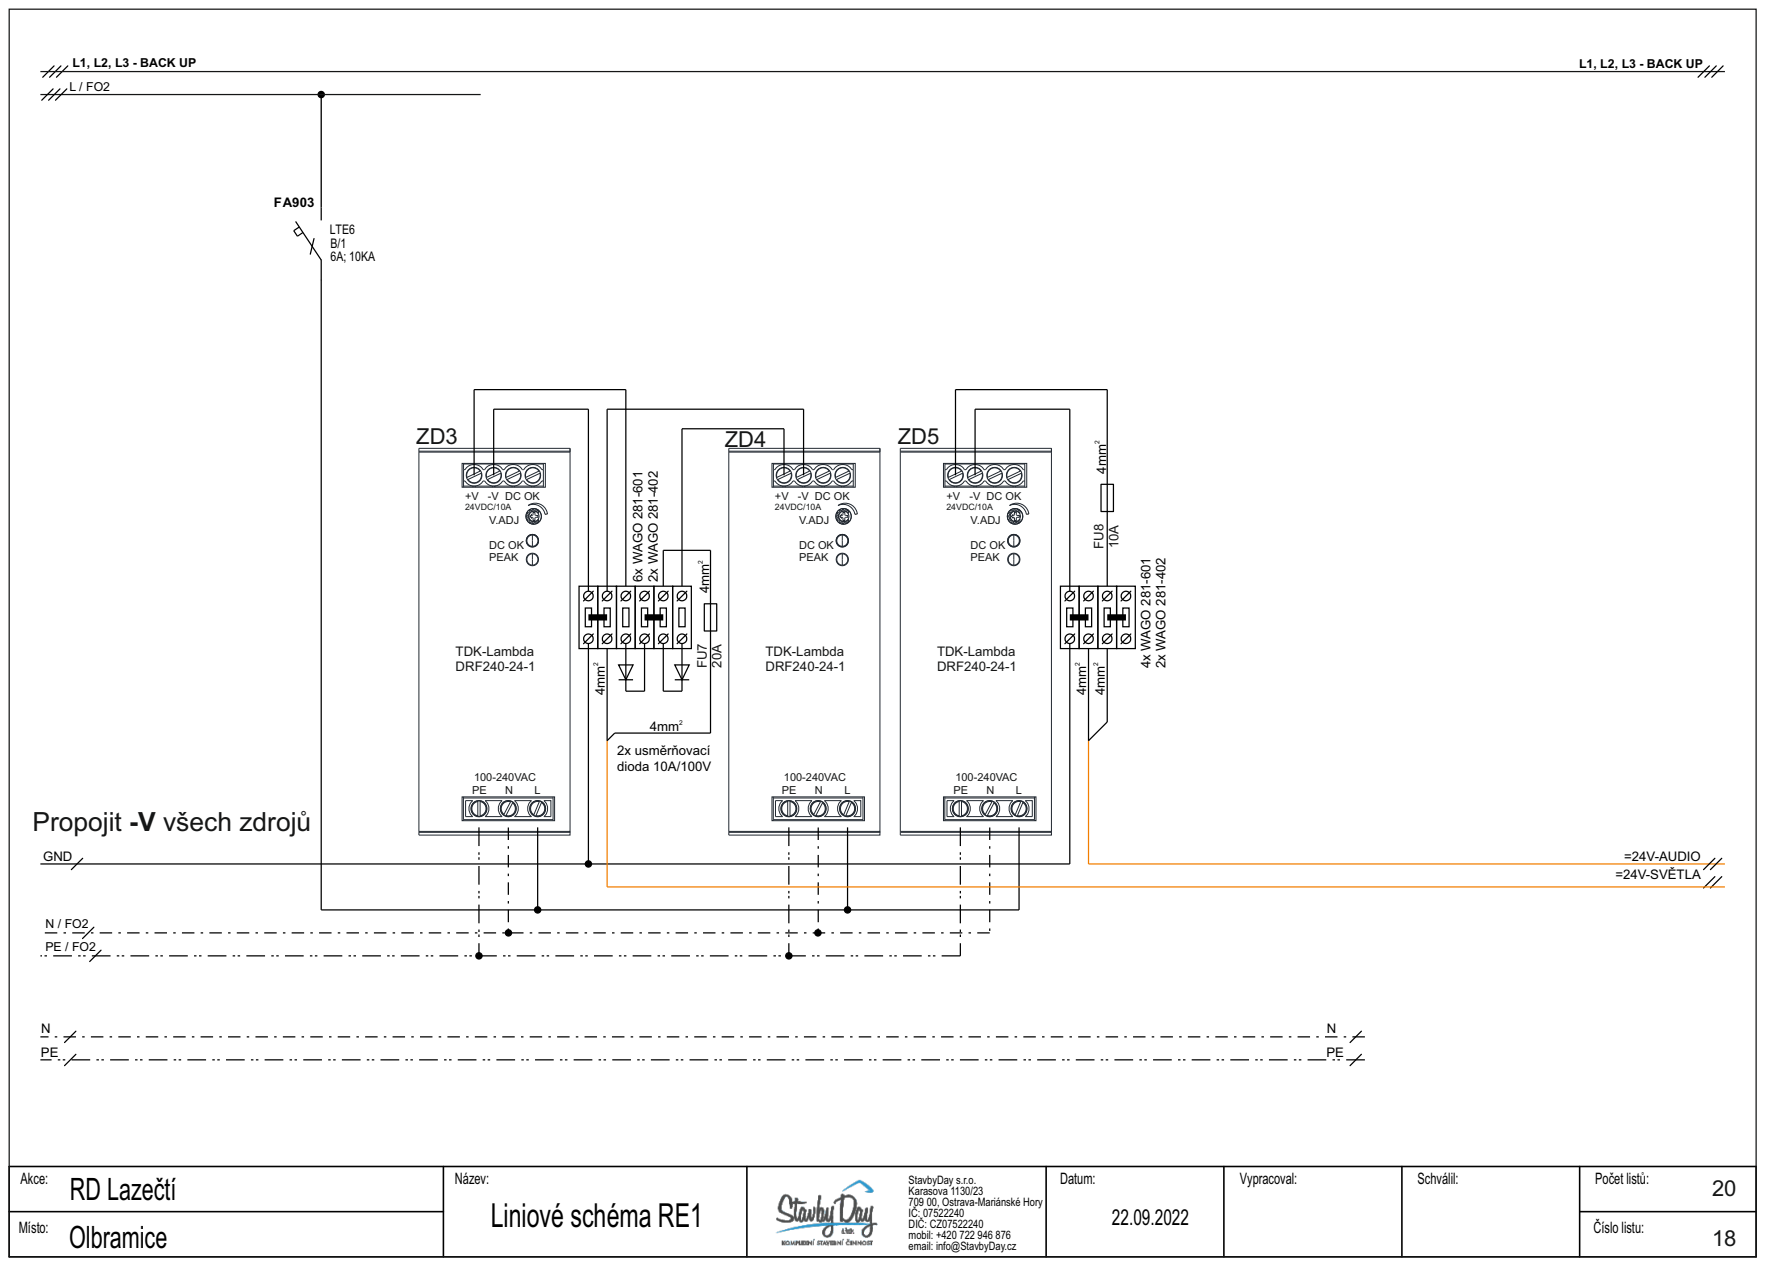
[picture p20: page 18]
=24V-SVĚTLA; +V -V DC OK 24VDC/10A V.ADJ; DC OK PEAK; TDK-Lambda DRF240-24-1; 100-240VAC; 6x WAGO 281-601; 2x WAGO 281-402; 2x usměrňovací dioda 10A/100V; 4x WAGO 281-601; GND; =24V-AUDIO; LTE6 B/1 6A; 10KA; L1, L2, L3 - BACK UP

Propojit -V všech zdrojů

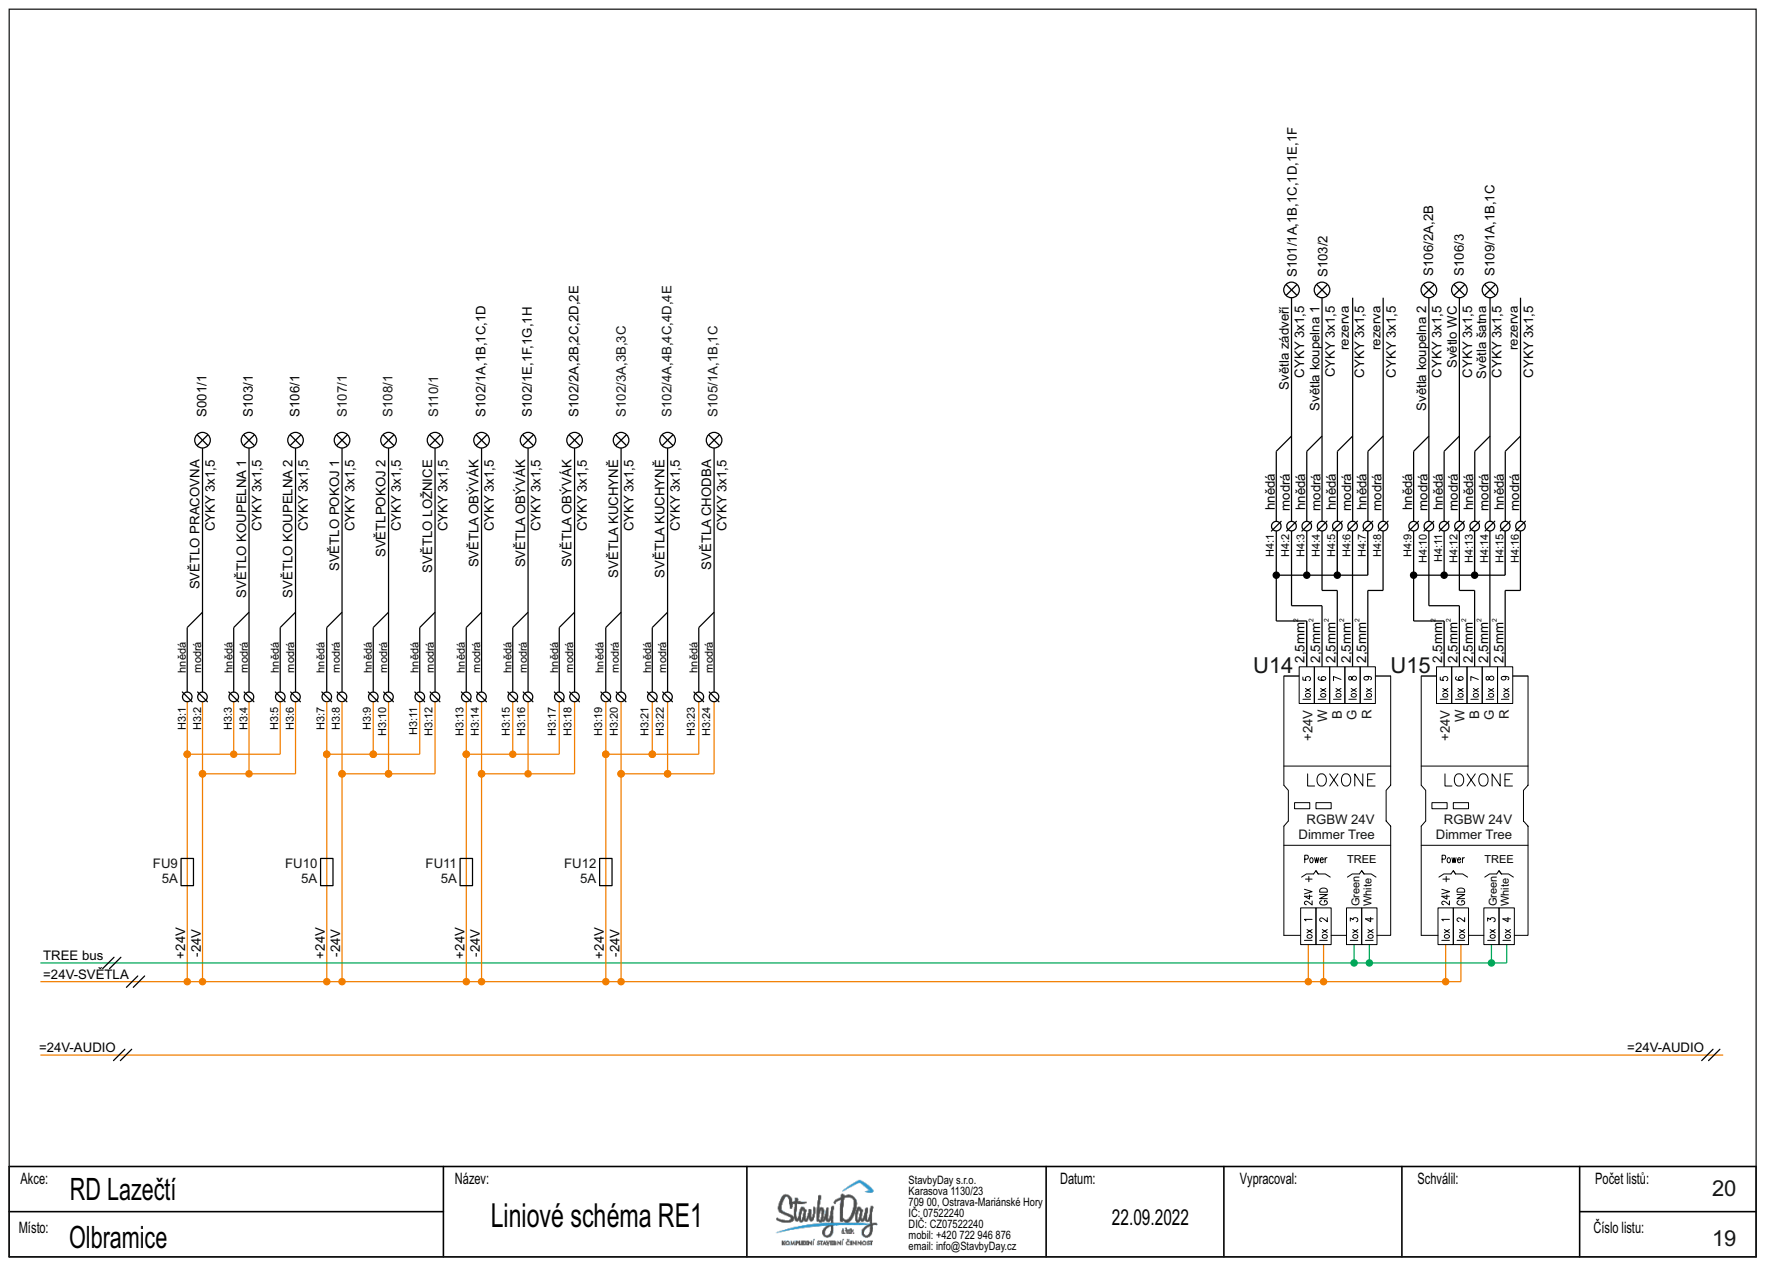
[picture p21: page 19]
SVĚTLO POKOJ 1; CYKY 3x1,5 S107/1; SVĚTLPOKOJ 2; CYKY 3x1,5; SVĚTLO PRACOVNA; SVĚTLO KOUPELNA 1; SVĚTLO KOUPELNA 2; hnědá; modrá; SVĚTLO LOŽNICE; =24V-SVĚTLA; RGBW 24V; rezerva; Světla koupelna 2; Světlo WC; Světla šatna; CYKY 3x1,5 S109/1A,1B,1C; Světla zádveří; Světla koupelna 1; TREE bus; =24V-AUDIO; SVĚTLA KUCHYNĚ; CYKY 3x1,5 S102/3A,3B,3C; SVĚTLA OBÝVÁK; SVĚTLA CHODBA

Dimmer Tree ⁺²⁴V

TREE Green White

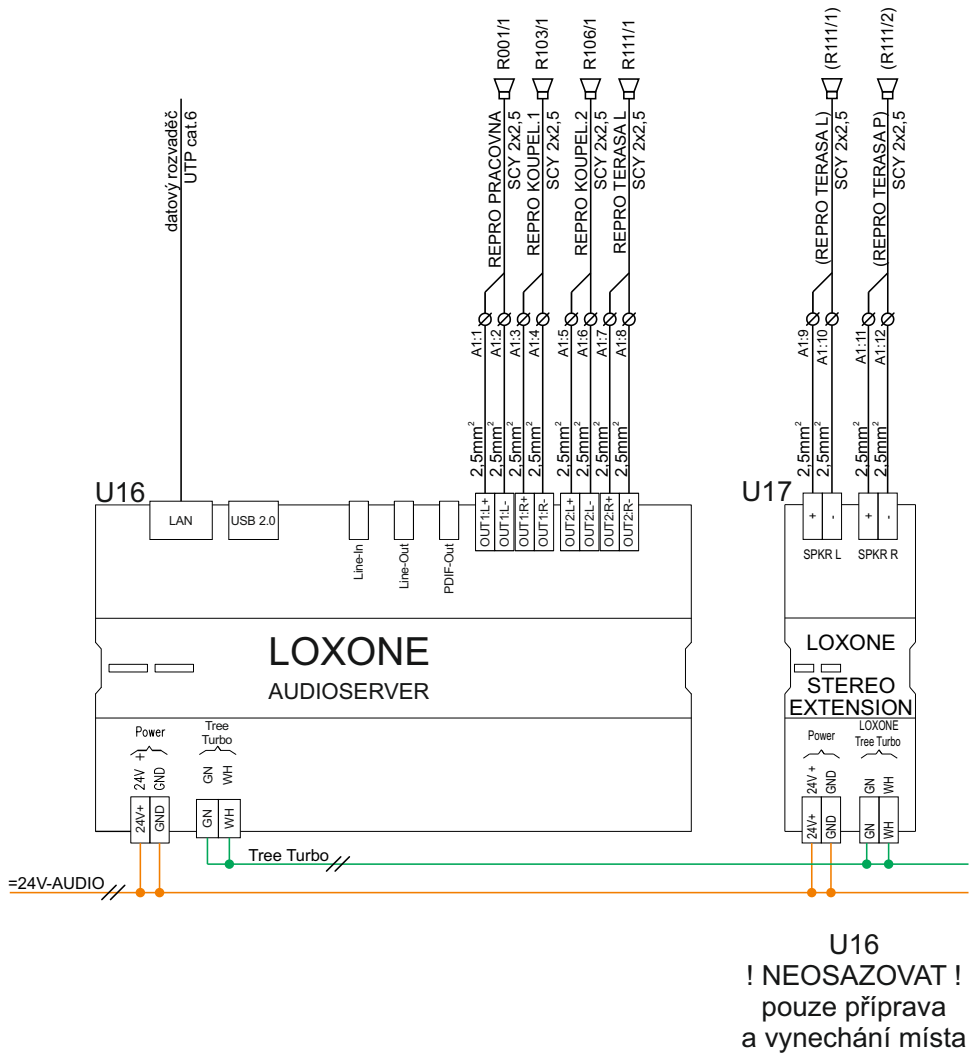
[picture p22: page 20]
=24V-AUDIO; Line-Out; Line-In; PDIF-Out; LAN; USB 2.0; GND; Tree Turbo; LOXONE; AUDIOSERVER; OUT2:L+; OUT2:L-; OUT2:R+; OUT2:R-; OUT1:L+; OUT1:L-; OUT1:R+; OUT1:R; REPRO PRACOVNA; SCY 2x2,5; REPRO KOUPEL.1; REPRO KOUPEL.2; REPRO TERASA L; datový rozvaděč; UTP cat.6; EXTENSION; STEREOGNWH; LOXONE Tree Turbo; Power; SPKR L; SPKR R; (REPRO TERASA L); (REPRO TERASA P); U16 ! NEOSAZOVAT ! pouze příprava a vynechání místa
