oukej1/Home-automation/House_Loucka/Rozvadece/Rozvaděč RH1.pdf

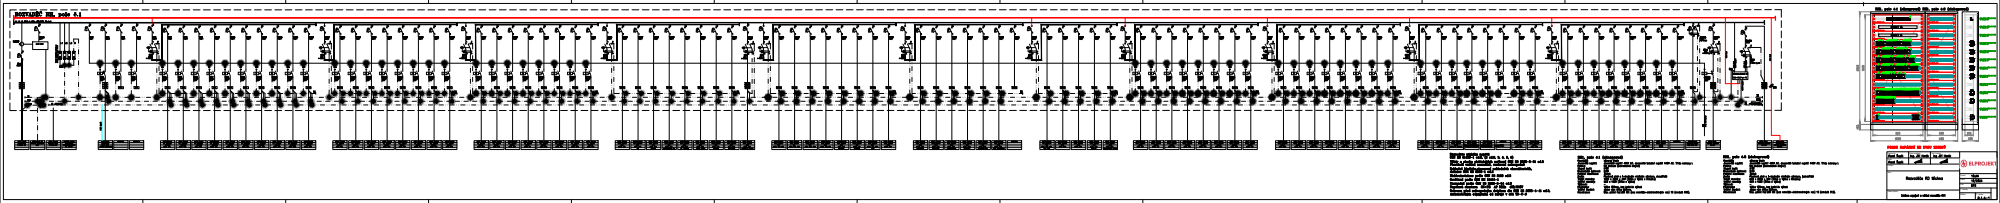
[picture p23: page 1]
Vypracoval; Zodp. projektant; Tech. kontrola; Obsah výkresu; Č. zakázky; Měřítko; Č. výkresu
