oukej1/Home-automation/House_Loucka/Rozvadece/Rozvaděč RP1.pdf

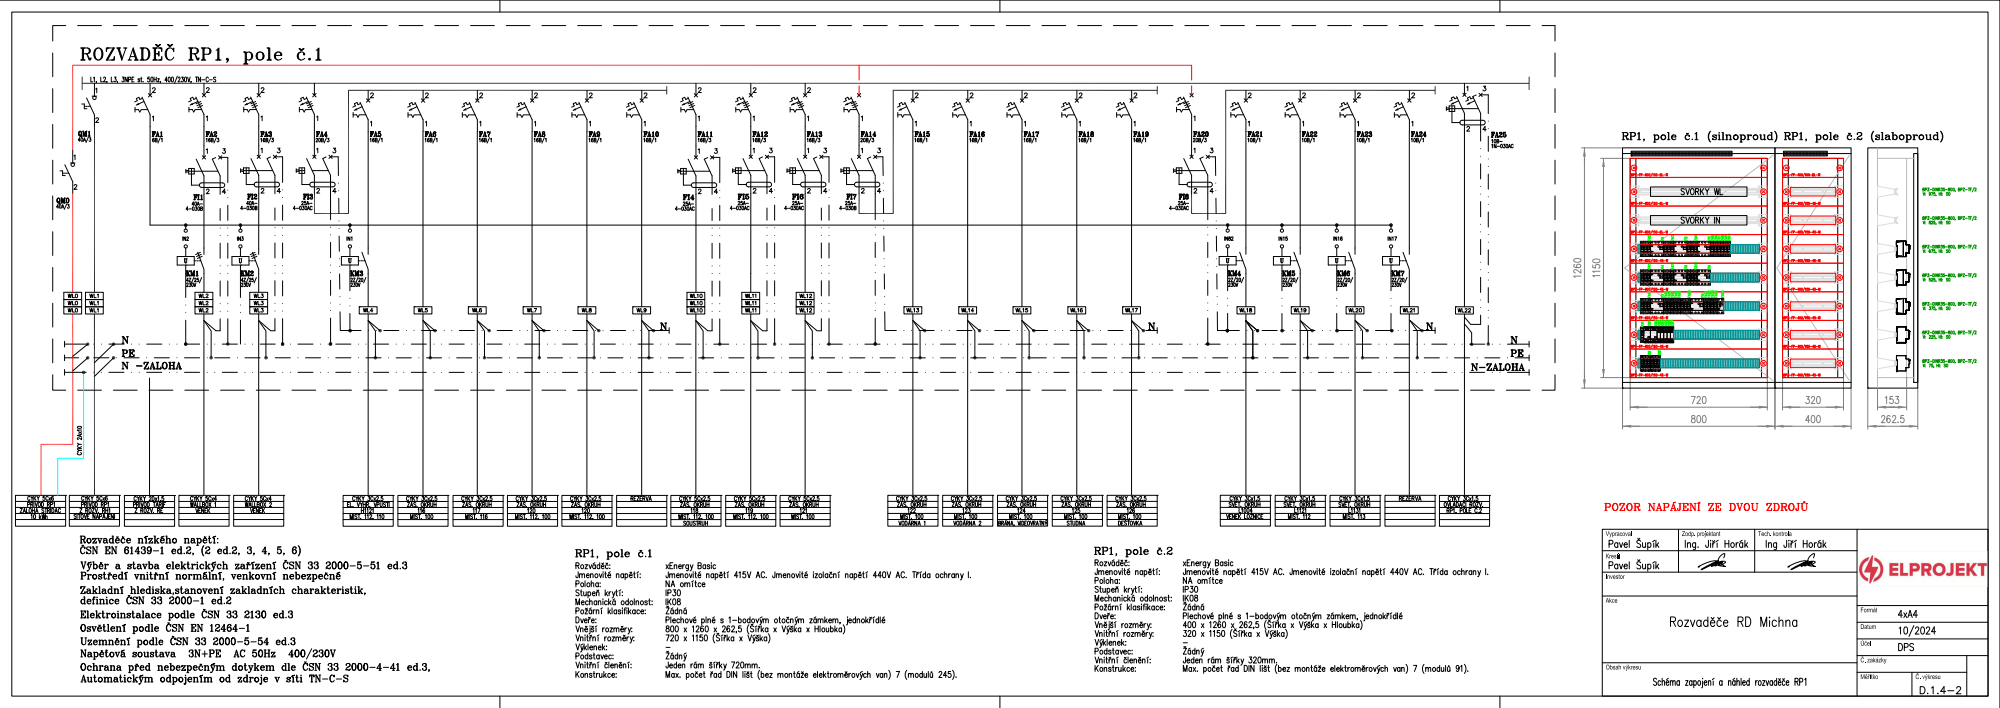
[picture p24: page 1]
