oukej1/Home-automation/House_Loucka/Rozvadece/Archive/Rozvaděč RH1.pdf

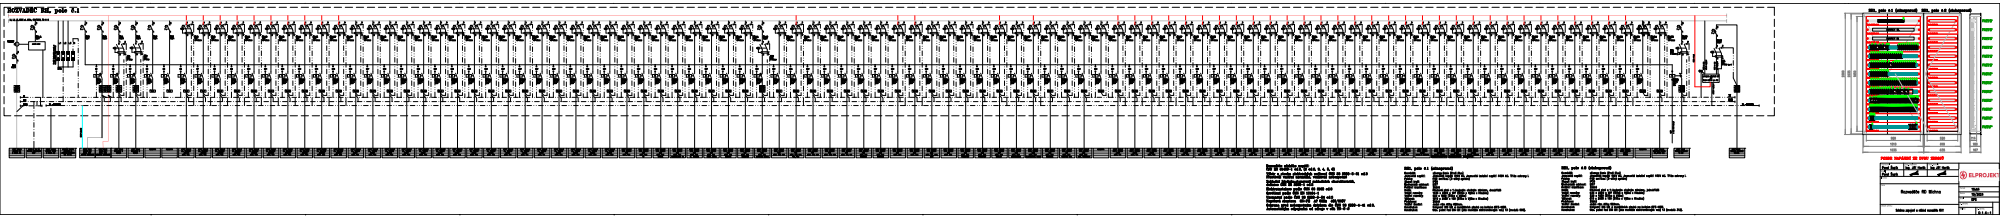
[picture p25: page 1]
