oukej1/Home-automation/House_Loucka/Rozvadece/Archive/Rozvaděč RP1.pdf

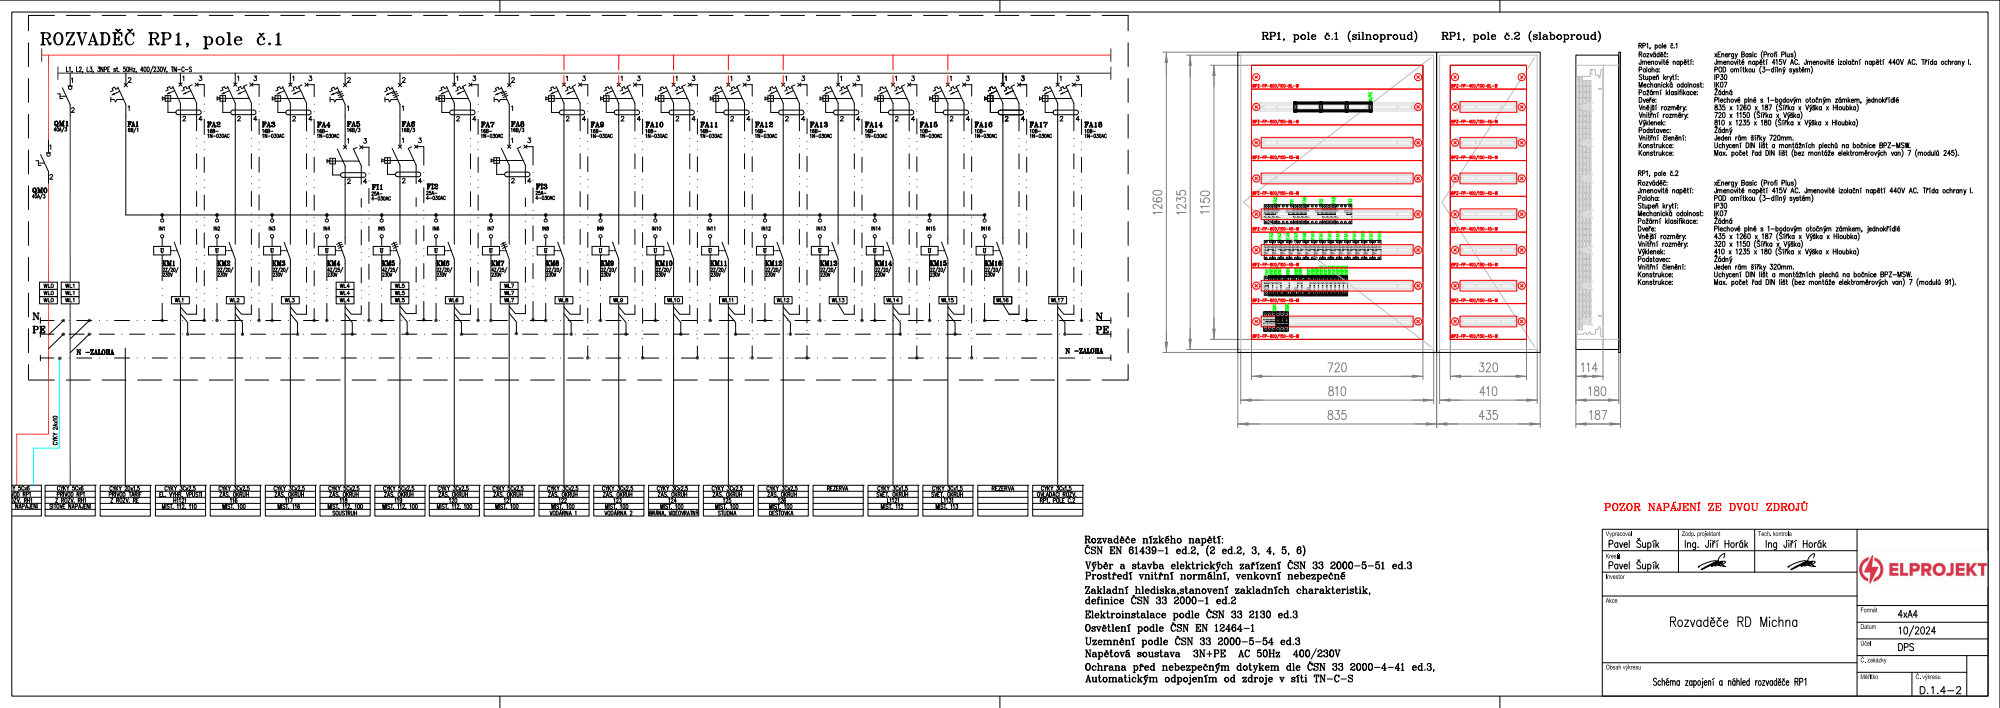
[picture p26: page 1]
