oukej1/Home-automation/House_Loucka/PCB/DS18B20_PCB/DS18B20_PCB.kicad_pcb

## KiCad design House_Loucka/PCB/DS18B20_PCB/DS18B20_PCB.kicad_pcb (2025-03-27)

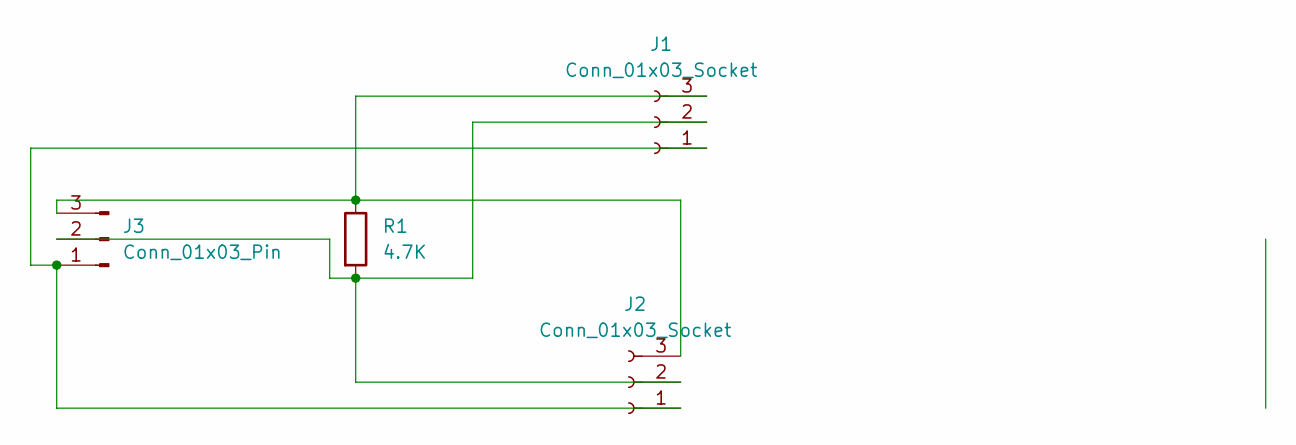
[picture p27: schematic DS18B20_PCB.kicad_sch]

Parts:
J1, J2: Conn_01x03_Socket; PinSocket_1x03_P2.54mm_Vertical_SMD_Pin1Left
J3: Conn_01x03_Pin; PinSocket_1x03_P2.54mm_Vertical_SMD_Pin1Right
R1: 4.7K; R_0201_0603Metric

Connections:
unnamed: J1.1, J2.1, J3.1
unnamed: J1.2, J2.2, J3.2, R1.2
unnamed: J1.3, J2.3, J3.3, R1.1

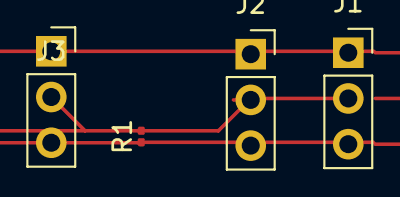
[picture p28: board DS18B20_PCB.kicad_pcb from above]

Board: 2 copper layers, 4 parts (0 on the bottom side), 3 nets.
