oukej1/Home-automation/(commit log)

2024-04-29 Adding of original file with sensor list
    [Rozpis_materialu.ods]
2024-04-29 Creation of folders for Loučka and Hůrka
    [Rozpis_materialu.ods]
2024-04-29 Adding of CO2 sensors scenarion, creation of sheets in Rozpis_materialu.ods for lights, sockets, shutters
    [Rozpis_materialu.ods]
2024-04-30 odstranění senzorů CO2 z koupelen, přidání jednoho TSL ven na fasádu
    [Rozpis_materialu.ods]
2024-05-06 Adding of data cables calculation
    [Rozpis_materialu.ods]
2024-05-07 file with cable prices added
    [Kabely.ods]
2024-05-07 reference in file cabely added for sockets
    [Kabely.ods]
2024-05-08 Harmonization of file Rozpis_materialu.ods
    [Rozpis_materialu.ods]
2024-05-08 fix of rozpis materialu ods
    [Sensor_Box_THCO_assembly.FCStd, Sensor_box.FCStd, Sensor_cover_Tem_hum_CO.FCStd]
2024-05-08 fix Rozpis_materialu.ods
    [Rozpis_materialu.ods]
2024-05-28 buttons added to 1NP_ELI.drawio
2024-05-28 Update 1NP_ELI.drawio - PIR sensors added
2024-05-28 Update 1NP_ELI.drawio - temperature sensors added
2024-05-28 Update 1NP_ELI.drawio - heating added
2024-05-28 Update 1NP_ELI.drawio - Heater added to room 111
2024-06-27 Pridana tabulka Eli_tabulky.ods
    [ELI_tabulky.ods]
2024-07-23 External light sensors added
2024-07-23 Sensor external added
2024-07-23 Heating added
2024-08-08 2NP added
    [ELI_tabulky.ods]
2024-08-17 Sound and missing items added
    [ELI_tabulky.ods]
2024-08-19 SocketsRenumbered 1NP_ELI.drawio
2024-08-19 Precislovani zasuvek
    [ELI_tabulky.ods]
2024-08-21 přidána FVE
    [ELI_tabulky.ods]
2024-12-14 Fix of kitchen in ELI tabulky
    [ELI_tabulky.ods]
2025-01-08 Added Arduino to lights
    [ELI_tabulky.ods]
2025-01-27 Přidána složka Rozvadece
    [ELI_tabulky.ods, Rozvaděče Michna.XLSX]
2025-02-01 Aktualizovat 1NP_ELI.drawio S100-3 switched to S109-8
2025-02-01 Aktualizovat 1NP_ELI.drawio - Added B1041, change buttones in 101
2025-02-18 DS18B20 - pcb folder added
    [DS18B20_PCB.kicad_pcb, DS18B20_PCB.kicad_sch]
2025-02-18 Rozvaděče převedeny na dxf
    [ELI_tabulky.ods, Rozpis_materialu.ods]
2025-02-27 Vytvořen soubor Vypocet_slaboproudy_Rozvadec.ods a aktualizace rozvodů
    [DS18B20_PCB.kicad_sch]
2025-03-08 Kicad PCB files created
2025-03-08 Sync of files between locations
    [ELI_tabulky.ods, Rozpis_materialu.ods, Vypocet_slaboproudy_Rozvadec.ods]
2025-03-27 Update PCB DS18B20 tables updated
    [DS18B20_PCB.kicad_pcb, DS18B20_PCB.kicad_sch, DS18B20_PCB_Wiring.kicad_sch]
2025-03-27 Update tabulek
    [Rozvaděče Michna ver 3.XLSX, Rozvaděče Michna ver 4.xlsx, Rozvaděče Michna.XLSX]
2025-03-27 Auto stash before merge of "main" and "origin/main"
    [ELI_tabulky.ods]
